KongXiangjie9612/Fruits-picking/文件/参考文献/201430220506邓镇汝/交201430220506邓镇汝/毕业设计二维/手柄的连接件-Model.jpg

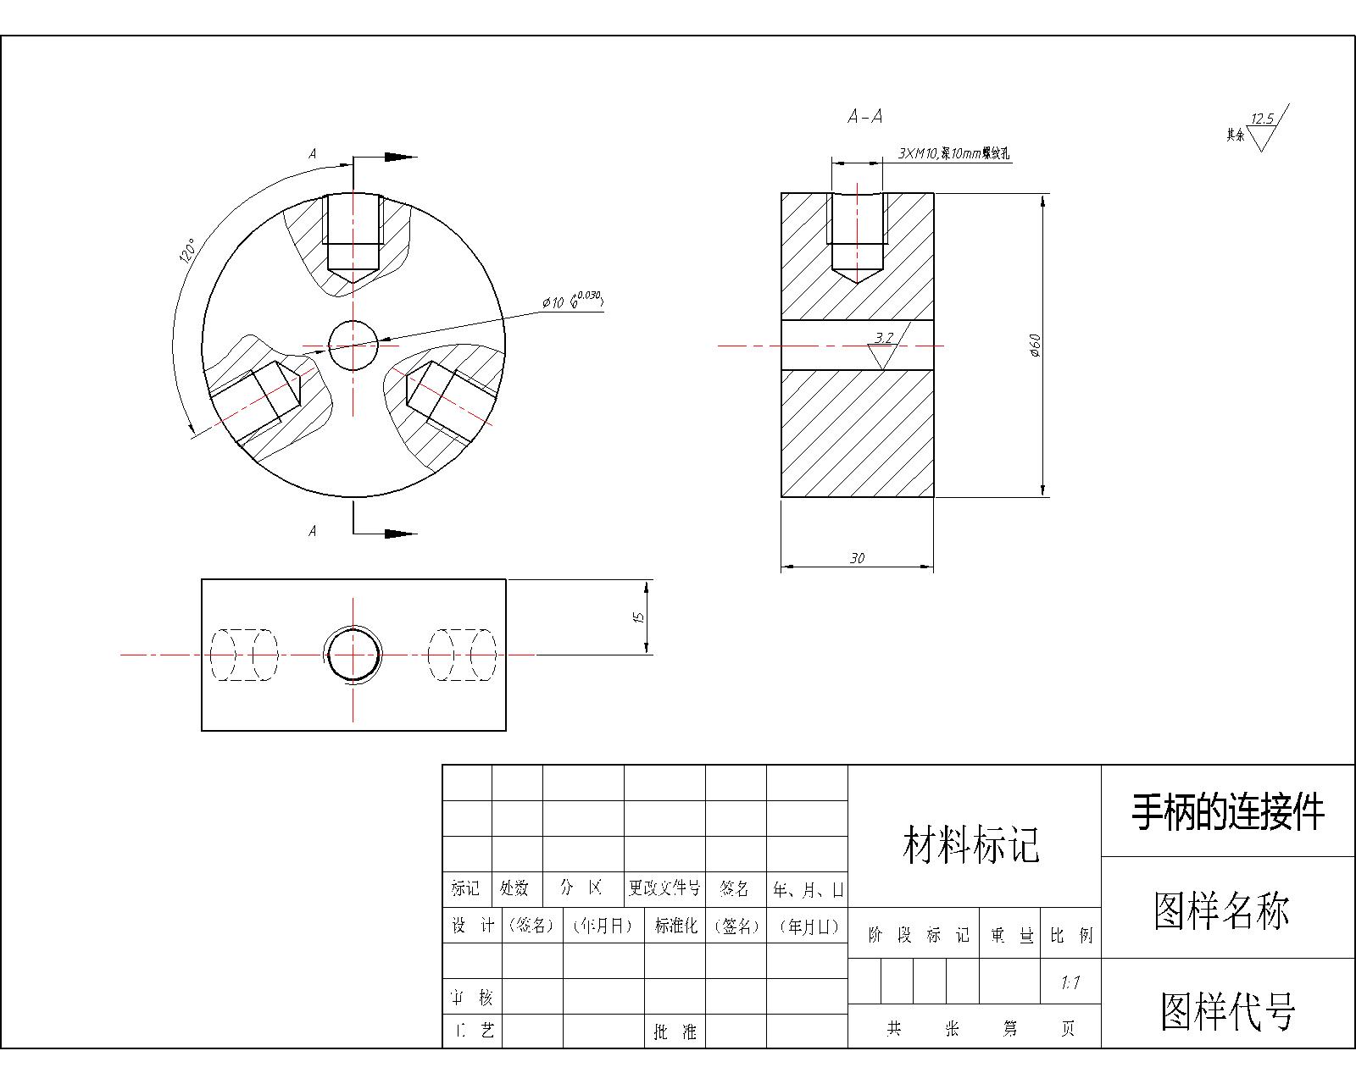
文件/参考文献/201430220506邓镇汝/交201430220506邓镇汝/毕业设计二维/手柄的连接件-Model.jpg
