KongXiangjie9612/Fruits-picking/文件/设计图纸/手持式震动采摘_零件清单.xlsx

物料名称 | 类型 | 型号规格 | 材质 | 单价 | 单机用量 | 总额 | 状态 | 入库时间 | 备注 | 购买地址
直线滑动轴承 | 加工件 | 16*23*20（内径*外径*长度） | 黄铜 | 15 | 20 | 300 |  |  |  | https://zhengkuanwj.tmall.com/shop/view_shop.htm?shop_id=110992629
