KongXiangjie9612/Fruits-picking/文件/参考文献/201430220506邓镇汝/交201430220506邓镇汝/毕业设计三维/测绘装配2.SLDASM

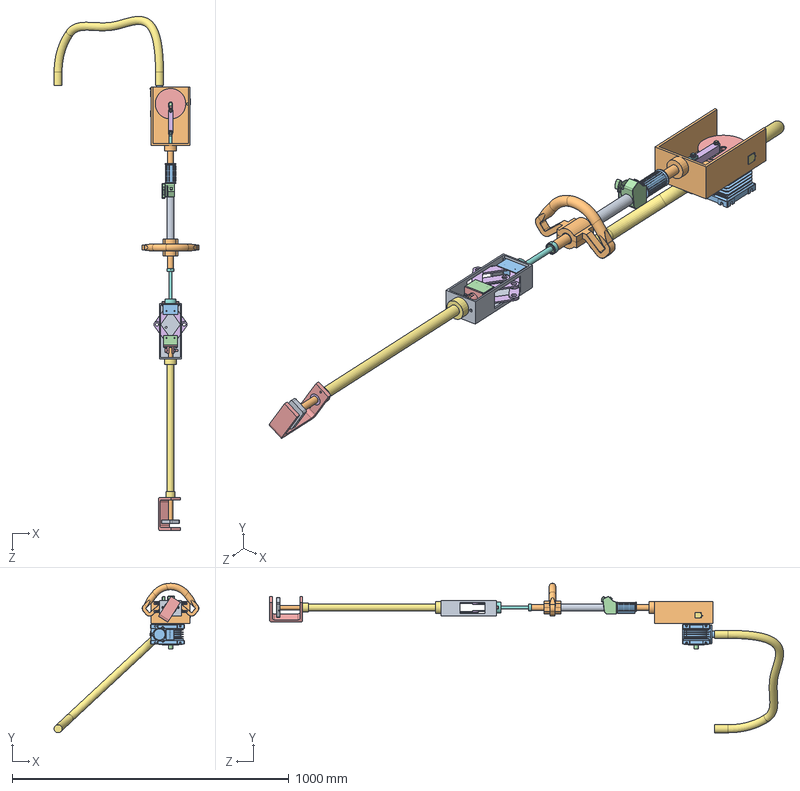
[picture p57: CAD file, 2018-09-26]
文件/参考文献/201430220506邓镇汝/交201430220506邓镇汝/毕业设计三维/测绘装配2.SLDASM
522.9 x 539.9 x 1855.7 mm
棘轮整体箱
伸出最长的长度
实际底
实际顶
连接结构2
杆 x 8
外部杆
后外部杆
顶片引用
测绘箱体杆
NMRV040测绘
测绘输出轴2
偏心盘测绘
测绘连杆1
测绘 主动销
测绘主动销2
plain washers for clevis pins gb x 2
测绘GB／T6172．1-2000六角薄螺母A级和B级M6 x 2
hexagon nuts with flange gb
测绘机箱滑动轴承16-22 x 2
测绘抓手
测绘机箱滑动轴承
紧钉管
铝管
测绘提手
测绘把手
测绘控制器
hexagon socket head cap screws gb x 5
hex nuts, style 1-grades ab gb x 5
手持震动采摘_转盘测速
