KongXiangjie9612/Fruits-picking/文件/参考文献/黄俊淮/3D建模/装夹部分.SLDASM

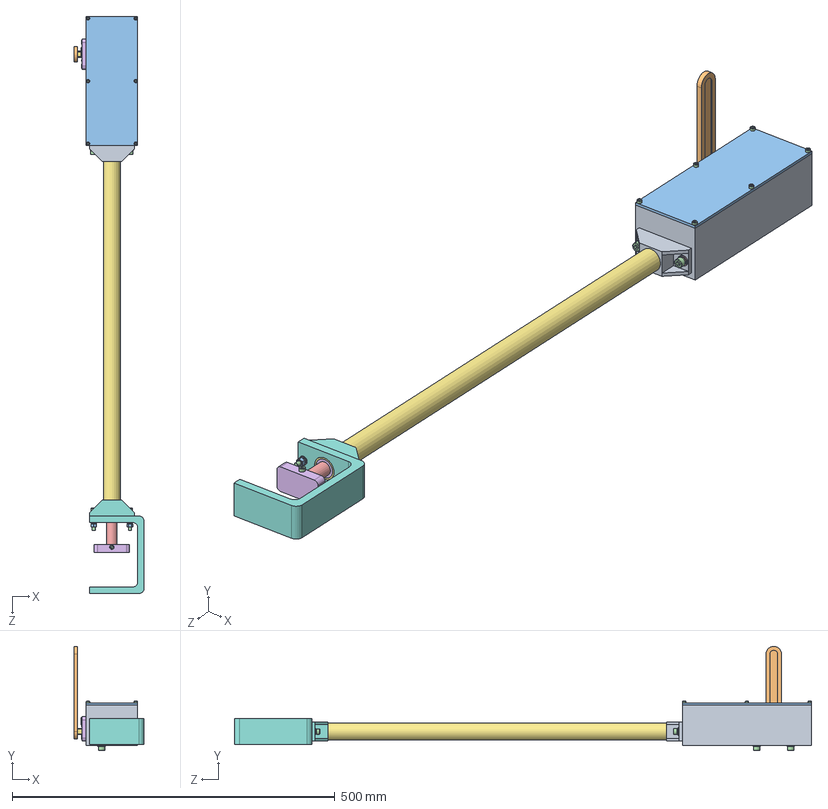
[picture p59: CAD file, 2018-09-17]
文件/参考文献/黄俊淮/3D建模/装夹部分.SLDASM
109.0 x 161.5 x 894.0 mm
棘轮整体箱
连杆2
曲柄1
棘轮轴承座
棘轮光杆2
棘轮壳
棘轮轴
棘轮凸轮
棘爪2
棘爪1
棘轮盖板
cross recessed countersunk head screws gb1
圆锥弹簧 x 2
顶片
棘轮箱杆
抓手
夹具销轴
棘轮连接扳手
hex nuts, style 1-grades ab gb x 14
hexagon socket head cap screws gb x 18
plain washers-n series-grade a gb x 19
机箱滑动轴承16-22 x 2
夹具销轴16
焊接筒
焊接筒2
spring lock washers--normal type gb x 8
cross recessed cheese head screws gb x 2
