KongXiangjie9612/Fruits-picking/文件/参考文献/黄俊淮/3D建模/装配体整体棘轮箱.SLDASM

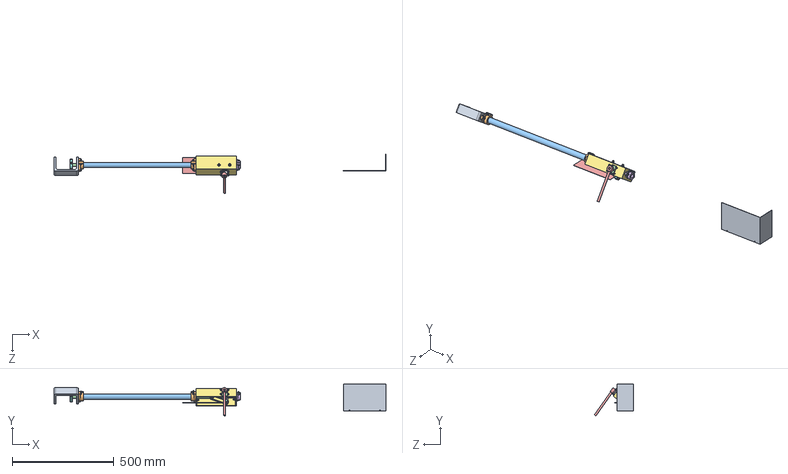
[picture p60: CAD file, 2018-09-17]
文件/参考文献/黄俊淮/3D建模/装配体整体棘轮箱.SLDASM
1634.9 x 157.5 x 194.0 mm
机箱滑动轴承16-22 x 2
棘轮箱杆
棘轮光杆2
棘轮连接扳手
曲柄1
连杆2
顶片
抓手
轴承支座26 x 2
hexagon socket head cap screws gb x 16
hex nuts, style 1-grades ab gb x 8
夹具销轴16
GB／T41-20001型六角螺母C级M5 x 2
夹具销轴
棘轮销钉
plain washers for clevis pins gb x 2
slotted set screws with cone point gb x 2
棘轮轴承座
hexagon nuts with flange gb x 2
棘轮箱轴承支座16
棘轮整体箱
