KongXiangjie9612/Fruits-picking/文件/参考文献/黄俊淮/3D建模/完整装配体.SLDASM

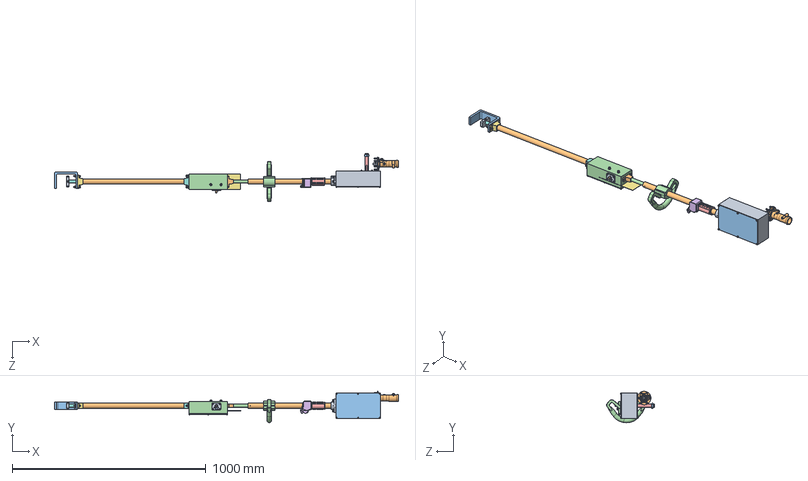
[picture p61: CAD file, 2018-09-17]
文件/参考文献/黄俊淮/3D建模/完整装配体.SLDASM
1776.1 x 162.7 x 247.0 mm
轴
轴套
hex lobular socket head cap screws-4.8 gb x 6
plain parallel keys
输出轴2
偏心盘
主动销
轴承支座26
管22-26
机箱滑动轴承16-22 x 4
箱体光杆
hexagon nuts with flange gb
hexagon socket head cap screws gb x 25
hex nuts, style 1-grades ab gb x 18
连杆1
软管连接套筒
M16薄螺母
提手
把手
控制器
plain washers for clevis pins gb x 2
slotted set screws with cone point gb
减速箱整体
销轴
棘轮整体箱
连杆2
曲柄1
棘轮轴承座
棘轮光杆2
棘轮壳
棘轮轴
棘轮凸轮
棘爪2
棘爪1
棘轮盖板
cross recessed countersunk head screws gb1 x 3
圆锥弹簧 x 2
顶片
棘轮箱杆
抓手
夹具销轴
plain washers-n series-grade a gb x 19
夹具销轴16
焊接筒
焊接筒2
spring lock washers--normal type gb x 8
中间连接焊块
棘轮箱盖板
GB_FASTENER_SCREWS_HSHCS M3X10-C x 6
