KongXiangjie9612/Fruits-picking/文件/参考文献/黄俊淮/3D建模/机构分析1.SLDASM

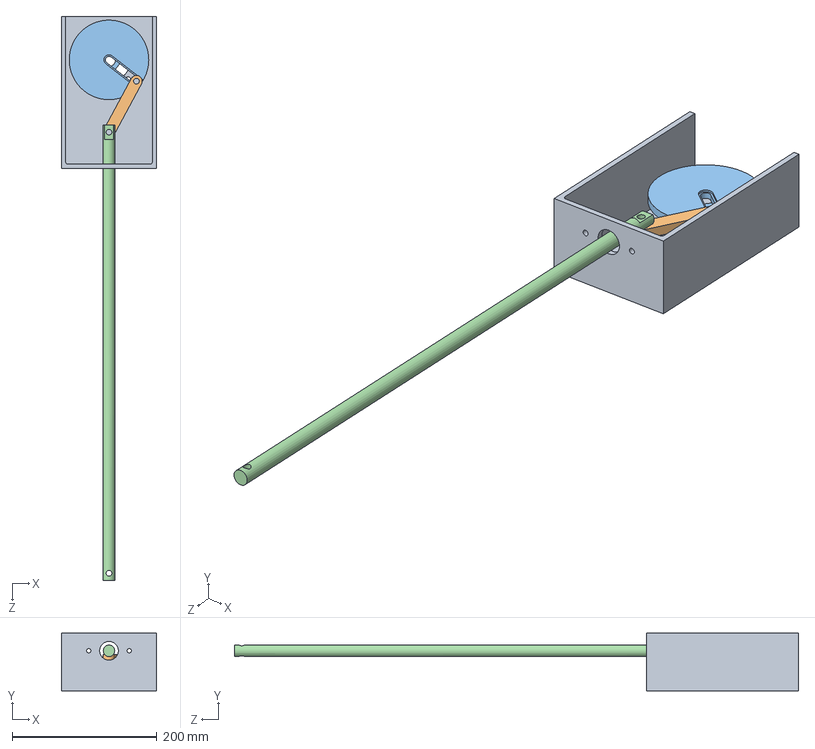
[picture p62: CAD file, 2018-09-17]
文件/参考文献/黄俊淮/3D建模/机构分析1.SLDASM
132.0 x 80.0 x 779.9 mm
减速箱整体
连杆1
偏心盘
箱体光杆
