KongXiangjie9612/Fruits-picking/文件/参考文献/李康镇/柑橘梳剪采收装置的设计-三维图/ASMBCP1.SLDASM

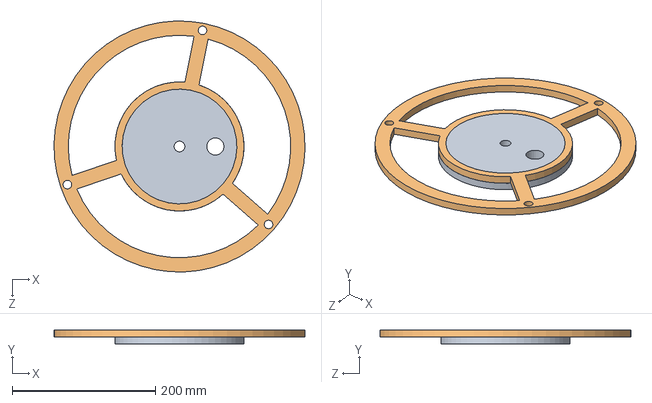
[picture p63: CAD file, 2018-09-17]
文件/参考文献/李康镇/柑橘梳剪采收装置的设计-三维图/ASMBCP1.SLDASM
349.9 x 20.0 x 349.8 mm
PRTYP1
PRTBCP2
