KongXiangjie9612/Fruits-picking/文件/参考文献/陈炜/1.2016.4.8/包含整体棘轮箱-最新/2016.01.06/装配体.SLDASM

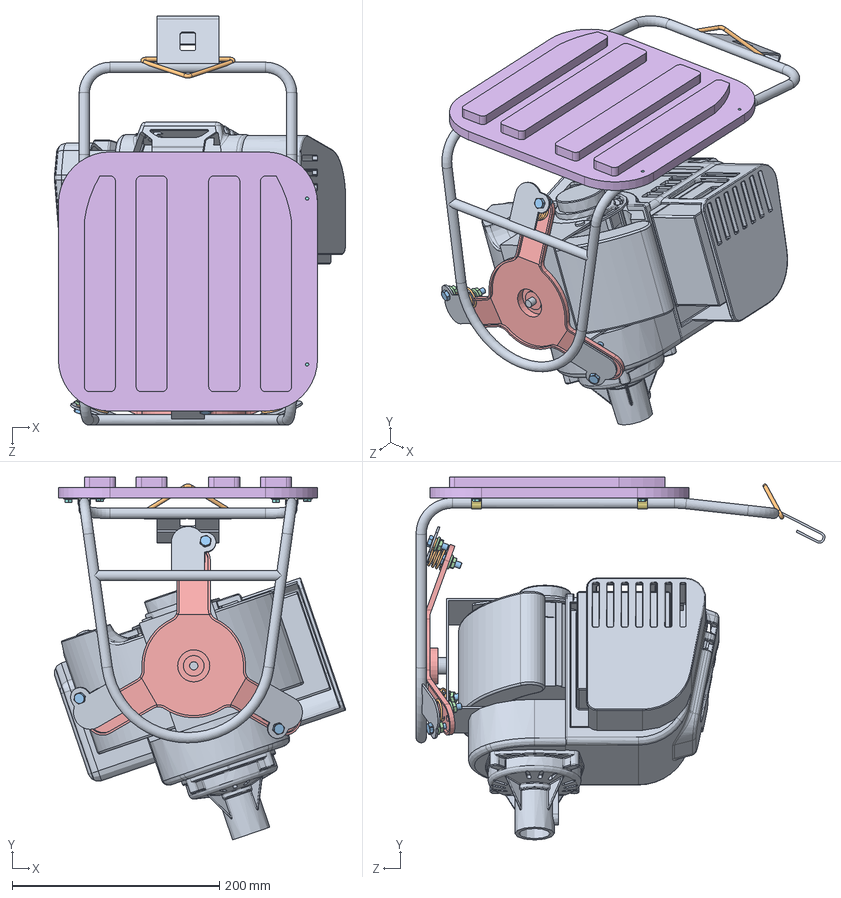
[picture p64: CAD file, 2018-09-17]
文件/参考文献/陈炜/1.2016.4.8/包含整体棘轮箱-最新/2016.01.06/装配体.SLDASM
280.9 x 350.0 x 394.5 mm
发动机支架
弹簧 x 3
hexagon head bolts-full thread gb x 7
hexagon nuts with flange gb x 6
支撑台
靠板
圆管夹块 x 4
hex bolts with slot on head grade ab gb x 8
汽油机
背带扣环
