KongXiangjie9612/Fruits-picking/文件/参考文献/黄俊淮/3D建模/零件/棘轮装配体.SLDASM

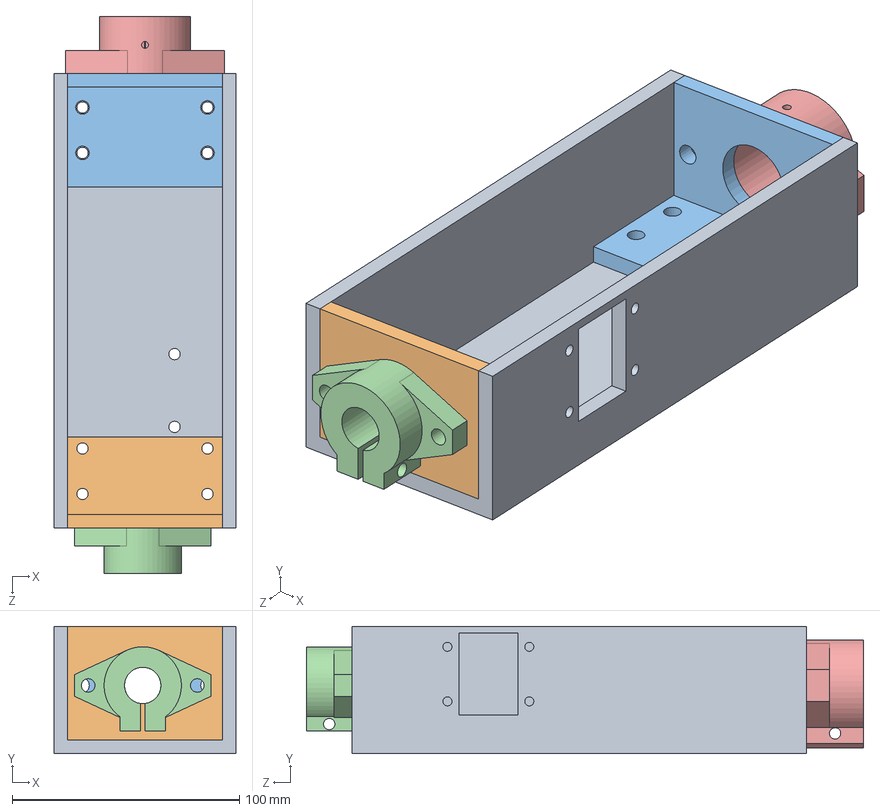
[picture p66: CAD file, 2018-09-17]
文件/参考文献/黄俊淮/3D建模/零件/棘轮装配体.SLDASM
80.0 x 56.0 x 245.0 mm
棘轮箱底板
棘轮箱端面
棘轮箱断面-25
棘轮箱轴承支座16
轴承支座26
