KongXiangjie9612/Fruits-picking/文件/参考文献/陈炜/1.2016.4.8/包含整体棘轮箱-最新/2016.01.06/装配体1.SLDASM

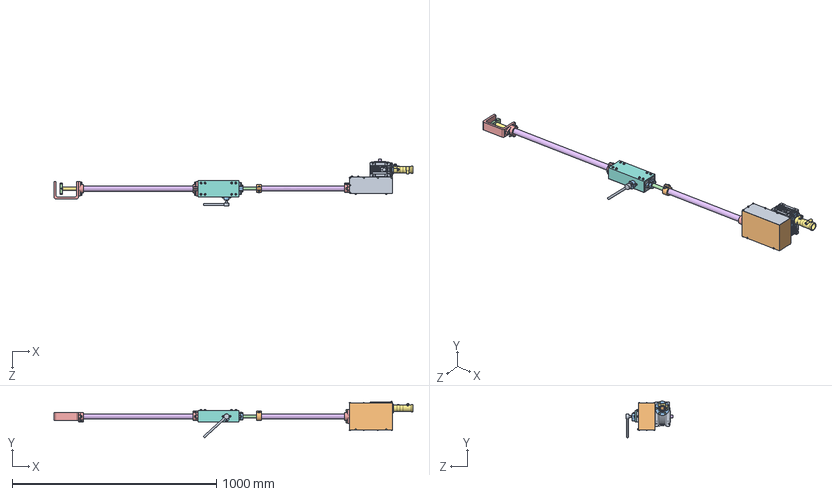
[picture p67: CAD file, 2018-09-17]
文件/参考文献/陈炜/1.2016.4.8/包含整体棘轮箱-最新/2016.01.06/装配体1.SLDASM
1755.7 x 179.8 x 231.2 mm
NMRV040
轴
轴套
hex lobular socket head cap screws-4.8 gb x 14
plain parallel keys
输出轴2
板1
直角板
底板 x 2
活动板
偏心盘
主动销
轴承支座26 x 3
管22-26
机箱滑动轴承16-22 x 4
棘轮箱底板
棘轮箱端面
棘轮箱断面-25
棘轮箱轴承支座16
箱体光杆
空心管16-20
棘轮箱杆
棘轮光杆
棘轮光杆2
棘轮连接扳手
曲柄1
连杆2
顶片
抓手
hexagon nuts with flange gb
hexagon socket head cap screws gb x 24
hex nuts, style 1-grades ab gb x 18
盖板
夹紧环
plain washers-l series-grades ac gb x 2
hexagon head bolts-full thread gb x 16
连杆1
夹具销轴 x 2
GB／T41-20001型六角螺母C级M5 x 7
棘轮轴承M8
主动销2
GB／T6172．1-2000六角薄螺母A级和B级M6 x 2
棘轮
棘轮轮齿
棘轮顶片
棘轮壳片
软管连接套筒
M5X25-N
