KongXiangjie9612/Fruits-picking/文件/参考文献/李康镇/柑橘梳剪采收装置的设计-三维图/电机装配体.SLDPRT.SLDASM

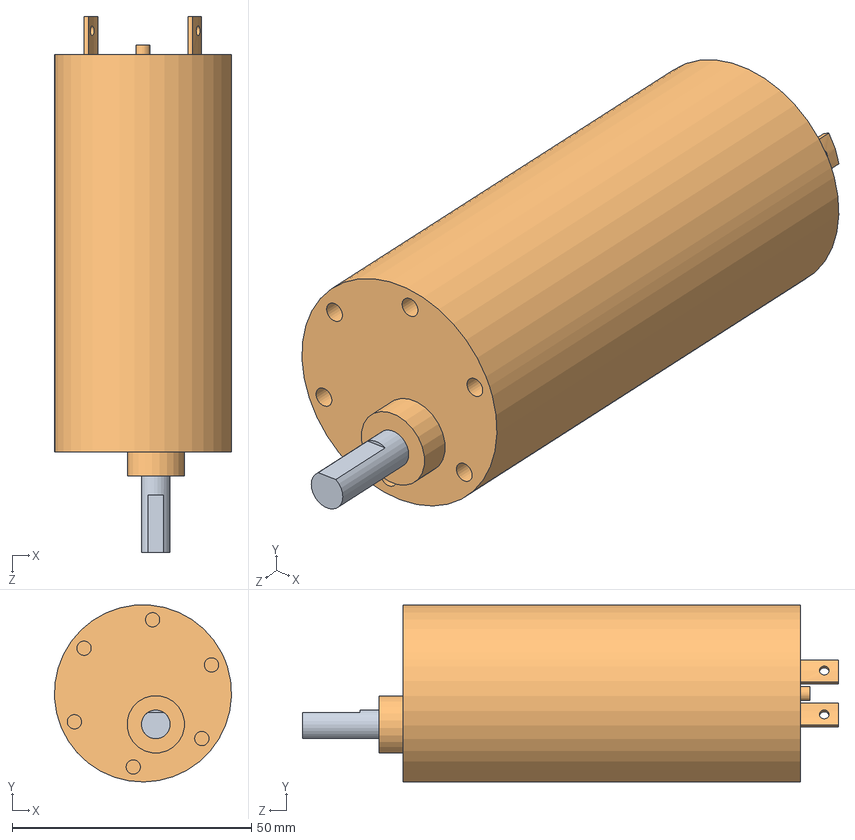
[picture p68: CAD file, 2018-09-17]
文件/参考文献/李康镇/柑橘梳剪采收装置的设计-三维图/电机装配体.SLDPRT.SLDASM
37.0 x 36.9 x 112.0 mm
电机输出轴
电机
