KongXiangjie9612/Fruits-picking/文件/参考文献/李康镇/柑橘梳剪采收装置的设计-三维图/薄膜开关2.SLDASM

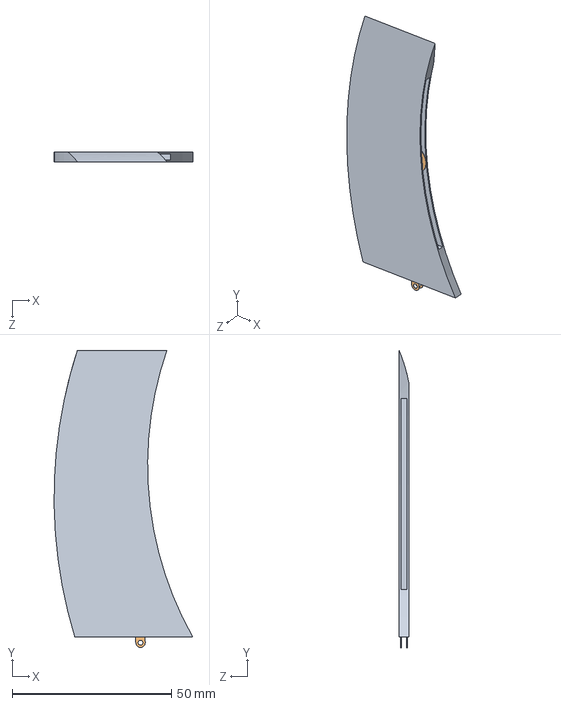
[picture p69: CAD file, 2018-09-17]
文件/参考文献/李康镇/柑橘梳剪采收装置的设计-三维图/薄膜开关2.SLDASM
43.6 x 93.2 x 3.00 mm
橡胶块2
引脚 x 2
