KongXiangjie9612/Fruits-picking/文件/参考文献/陈炜/1.2016.4.8/包含整体棘轮箱-最新/2016.01.06/装配体棘轮.SLDASM

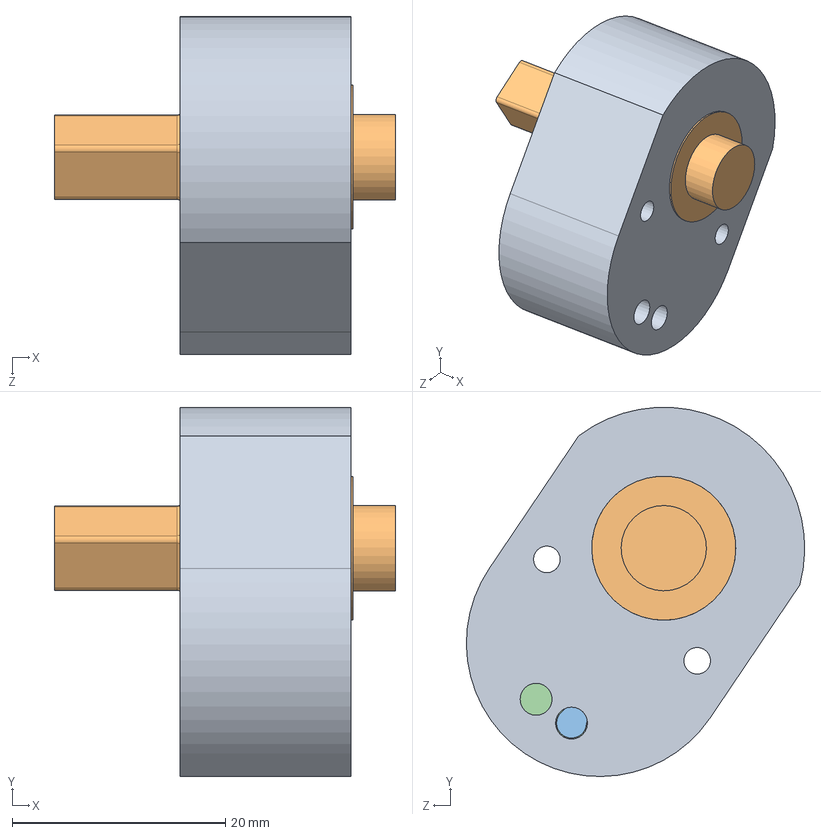
[picture p70: CAD file, 2018-09-17]
文件/参考文献/陈炜/1.2016.4.8/包含整体棘轮箱-最新/2016.01.06/装配体棘轮.SLDASM
32.0 x 34.6 x 31.7 mm
棘轮
棘轮轮齿
棘轮顶片
棘轮壳片
