KongXiangjie9612/Fruits-picking/文件/参考文献/李康镇/柑橘梳剪采收装置的设计-三维图/薄膜开关1.SLDASM

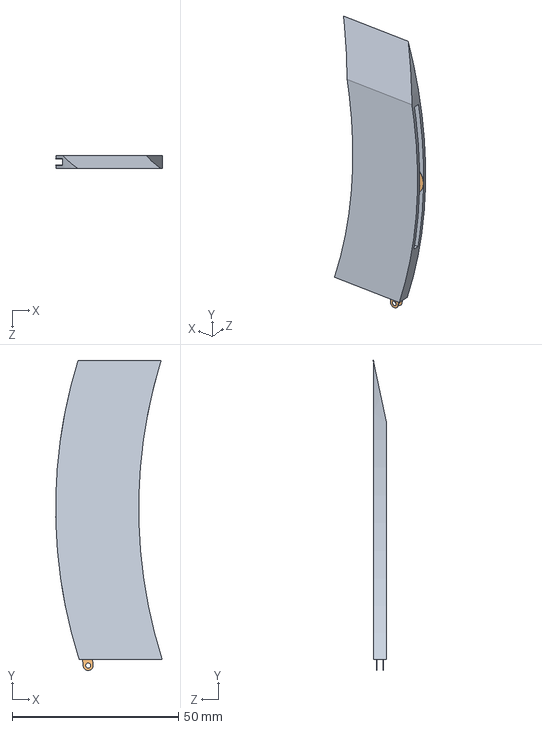
[picture p71: CAD file, 2018-09-17]
文件/参考文献/李康镇/柑橘梳剪采收装置的设计-三维图/薄膜开关1.SLDASM
32.1 x 93.2 x 4.00 mm
橡胶片
引脚 x 2
