KongXiangjie9612/Fruits-picking/文件/参考文献/陈炜/1.2016.4.8/包含整体棘轮箱-最新/2016.01.06/合叶.SLDASM

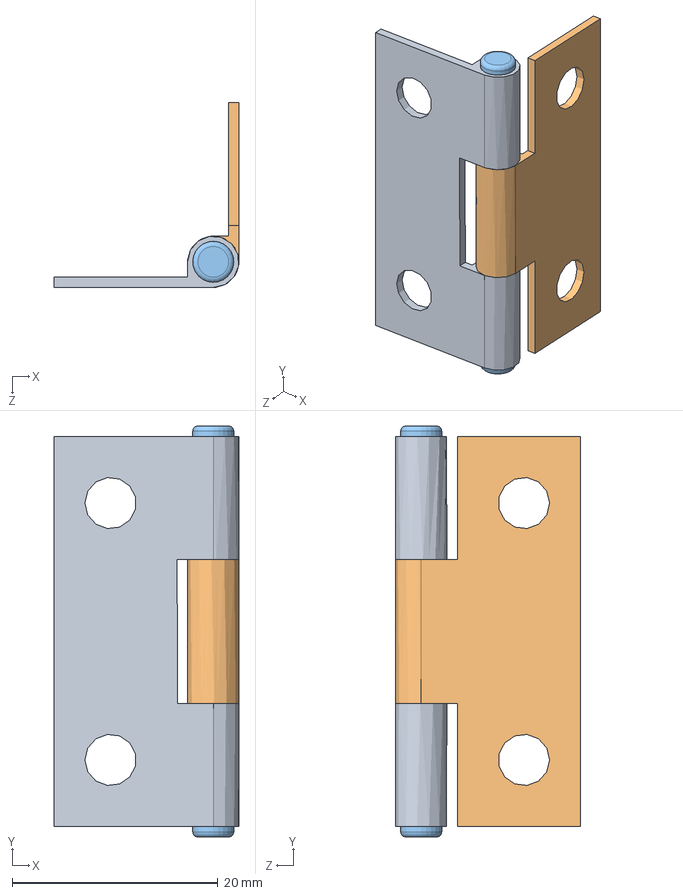
[picture p72: CAD file, 2018-09-17]
文件/参考文献/陈炜/1.2016.4.8/包含整体棘轮箱-最新/2016.01.06/合叶.SLDASM
18.0 x 40.0 x 18.0 mm
合叶片1
合叶片2
合叶销
