KongXiangjie9612/Fruits-picking/文件/参考文献/陈炜/1.2016.4.8/包含整体棘轮箱-最新/2016.01.06/装配体棘轮2.SLDASM

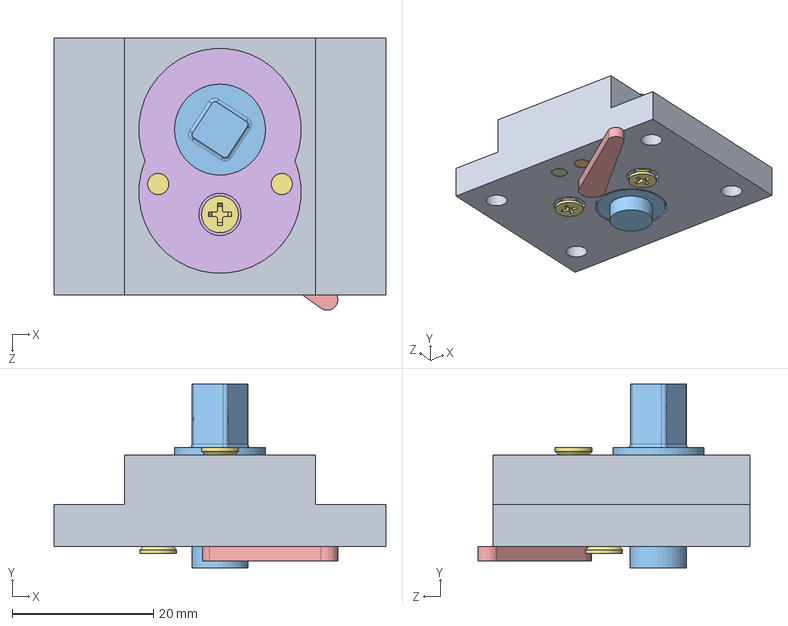
[picture p74: CAD file, 2018-09-17]
文件/参考文献/陈炜/1.2016.4.8/包含整体棘轮箱-最新/2016.01.06/装配体棘轮2.SLDASM
47.0 x 26.0 x 38.6 mm
棘轮壳
棘轮顶片右
棘轮轮齿
棘轮顶片
棘轮凸轮
棘轮盖板
cross recessed countersunk head screws gb2 x 3
