KongXiangjie9612/Fruits-picking/文件/设计图纸/毕业设计三维/测绘装配.SLDASM

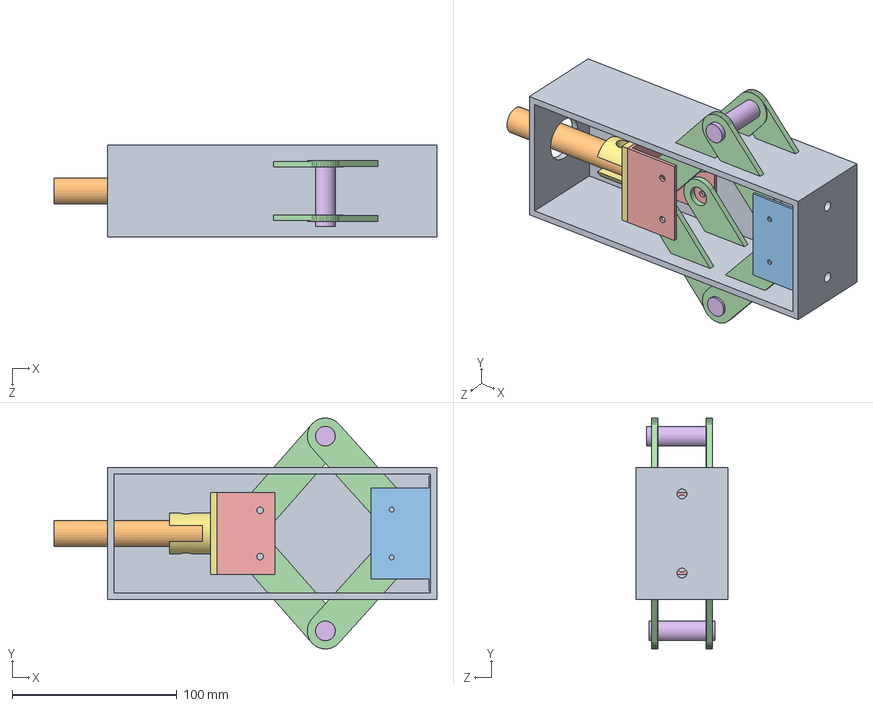
[picture p75: CAD file, 2018-09-17]
文件/设计图纸/毕业设计三维/测绘装配.SLDASM
232.3 x 140.1 x 56.0 mm
箱体
伸出最长的长度
实际底
杆 x 8
实际顶
中间连接 x 2
连接结构2
