KongXiangjie9612/Fruits-picking/文件/设计图纸/毕业设计三维/发动机装配体.SLDASM

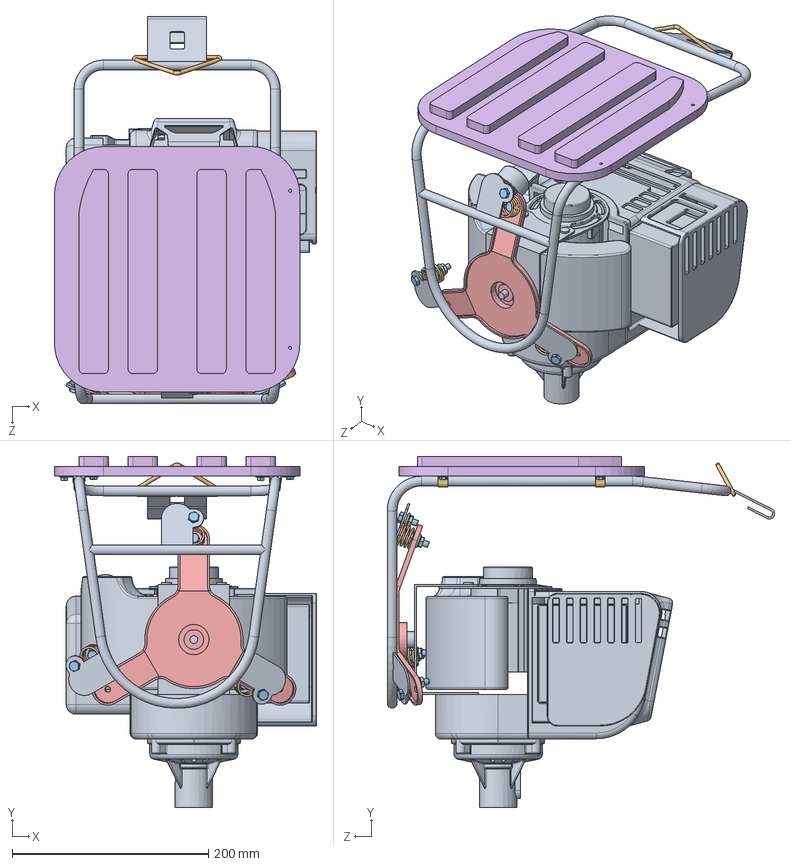
[picture p76: CAD file, 2018-09-17]
文件/设计图纸/毕业设计三维/发动机装配体.SLDASM
267.0 x 357.4 x 394.5 mm
发动机支架
弹簧 x 3
hexagon head bolts-full thread gb x 7
hexagon nuts with flange gb x 6
支撑台
靠板
圆管夹块 x 4
hex bolts with slot on head grade ab gb x 8
汽油机
背带扣环
