KongXiangjie9612/Fruits-picking/文件/参考文献/李康镇/柑橘梳剪采收装置的设计-三维图/梳齿装配体.SLDASM

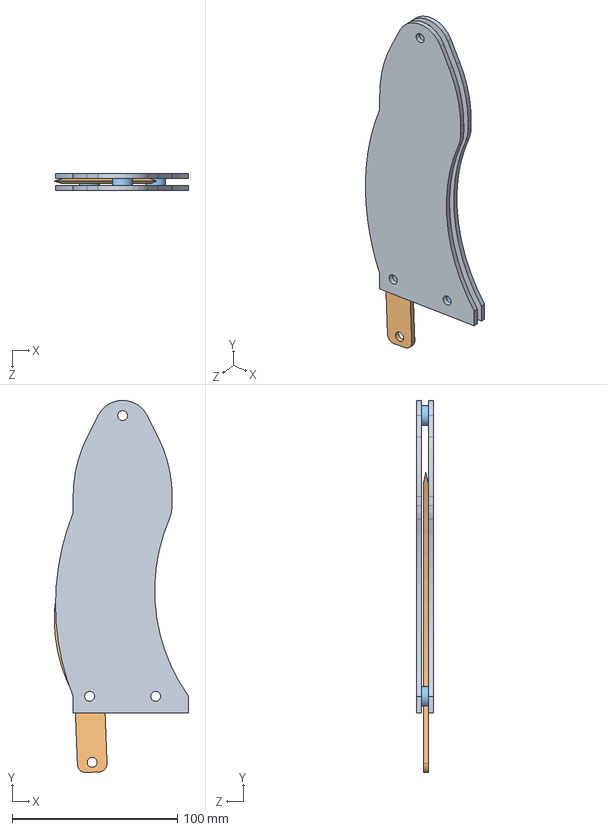
[picture p77: CAD file, 2018-09-17]
文件/参考文献/李康镇/柑橘梳剪采收装置的设计-三维图/梳齿装配体.SLDASM
81.4 x 225.3 x 10.0 mm
定刀片 x 2
动刀片
垫圈 x 3
