KongXiangjie9612/Fruits-picking/文件/设计图纸/毕业设计三维/测绘装配，只允许千进60毫米.SLDASM

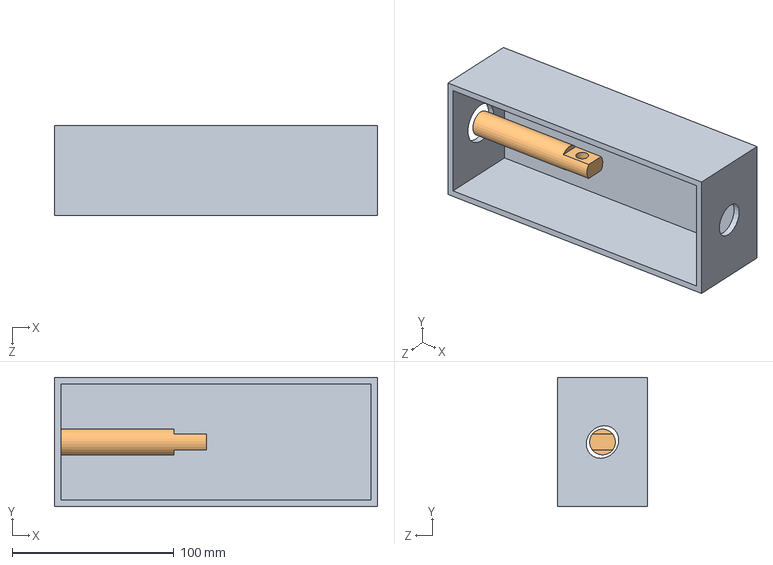
[picture p78: CAD file, 2018-09-17]
文件/设计图纸/毕业设计三维/测绘装配，只允许千进60毫米.SLDASM
200.0 x 80.0 x 56.0 mm
箱体
伸出最长的长度
