KongXiangjie9612/Fruits-picking/文件/参考文献/李康镇/柑橘梳剪采收装置的设计-三维图/曲柄摇杆机构.SLDASM

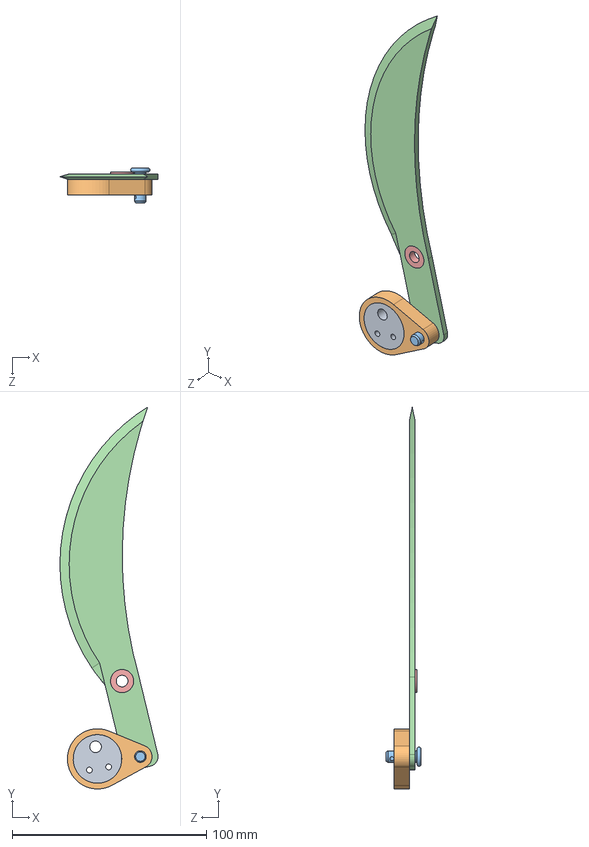
[picture p79: CAD file, 2018-09-17]
文件/参考文献/李康镇/柑橘梳剪采收装置的设计-三维图/曲柄摇杆机构.SLDASM
50.5 x 196.6 x 18.0 mm
偏心块
连杆2
M6-16销轴
动刀片
垫圈
