KongXiangjie9612/Fruits-picking/文件/参考文献/陈炜/1.2016.4.8/包含整体棘轮箱-最新/2016.01.06/棘轮装配体.SLDASM

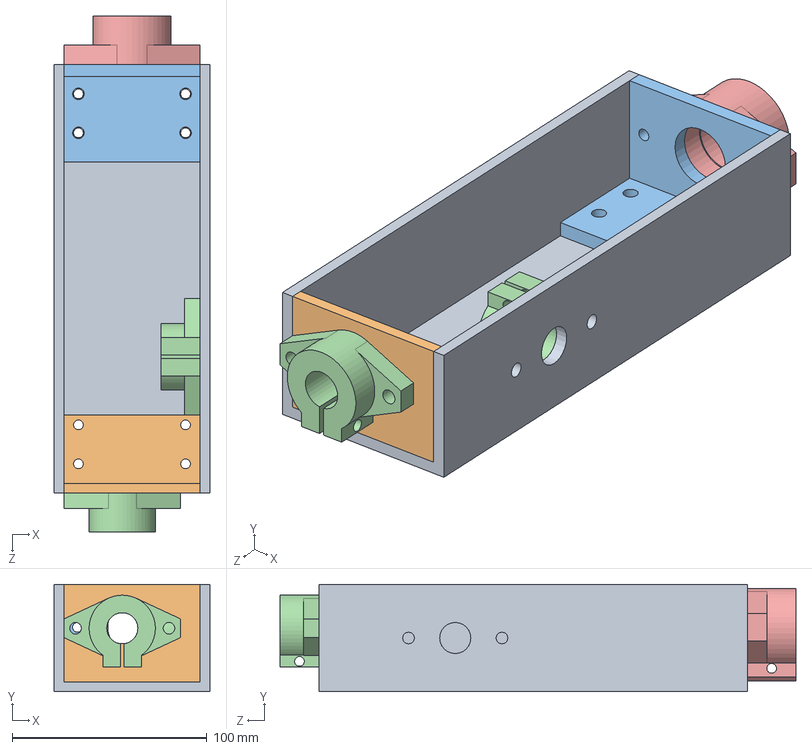
[picture p80: CAD file, 2018-09-17]
文件/参考文献/陈炜/1.2016.4.8/包含整体棘轮箱-最新/2016.01.06/棘轮装配体.SLDASM
80.0 x 55.0 x 265.0 mm
棘轮箱底板
棘轮箱端面
棘轮箱断面-25
棘轮箱轴承支座16 x 2
轴承支座26
