KongXiangjie9612/Fruits-picking/文件/参考文献/黄俊淮/3D建模/零件/减速箱.SLDASM

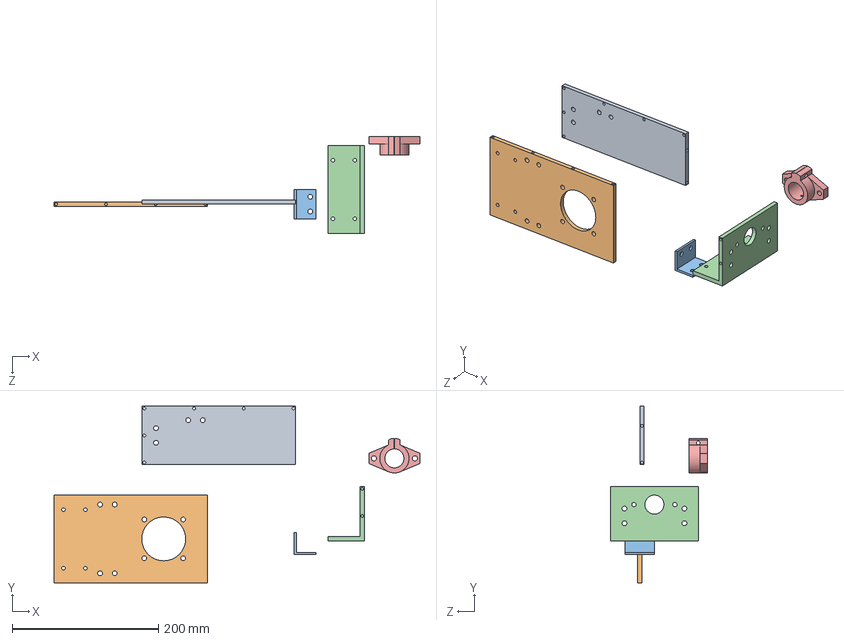
[picture p81: CAD file, 2018-09-17]
文件/参考文献/黄俊淮/3D建模/零件/减速箱.SLDASM
500.4 x 241.4 x 132.5 mm
底板
板1
固定角钢
直角板
轴承支座26
