KongXiangjie9612/Fruits-picking/文件/参考文献/陈炜/1.2016.4.8/包含整体棘轮箱-最新/2016.01.20/2016.01.20/装配体棘轮2.SLDASM

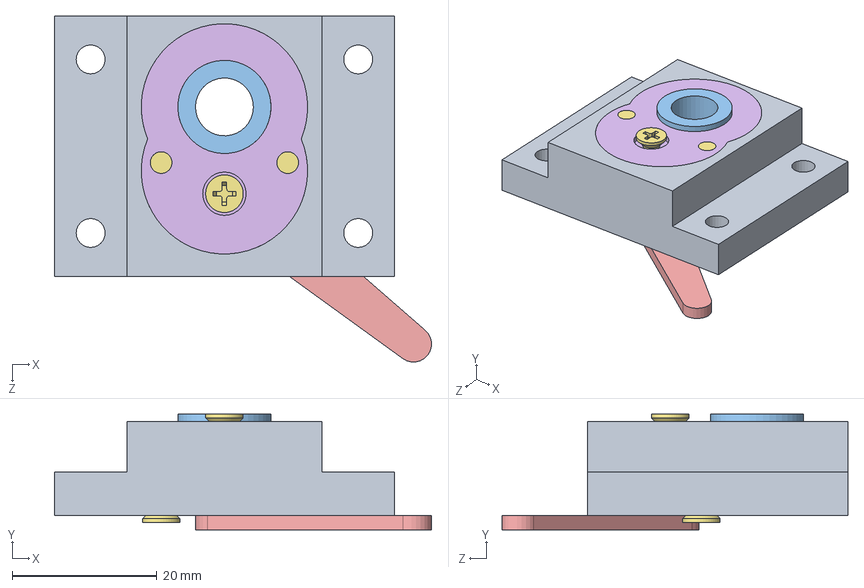
[picture p83: CAD file, 2018-09-17]
文件/参考文献/陈炜/1.2016.4.8/包含整体棘轮箱-最新/2016.01.20/2016.01.20/装配体棘轮2.SLDASM
52.1 x 16.0 x 47.8 mm
棘轮壳
棘轮顶片右
棘轮轮齿
棘轮顶片
棘轮凸轮
cross recessed countersunk head screws gb2 x 3
棘轮盖板
