KongXiangjie9612/Fruits-picking/文件/参考文献/李康镇/柑橘梳剪采收装置的设计-三维图/轴1.SLDPRT

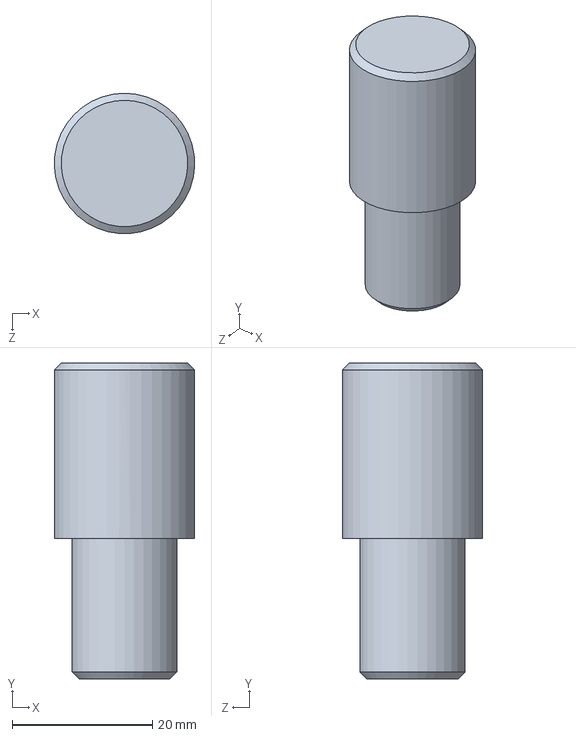
[picture p84: CAD file, 2018-09-17]
文件/参考文献/李康镇/柑橘梳剪采收装置的设计-三维图/轴1.SLDPRT
20.0 x 45.0 x 20.0 mm
