KongXiangjie9612/Fruits-picking/文件/参考文献/陈炜/1.2016.4.8/包含整体棘轮箱-最新/2016.01.06/GB／T6172．1-2000六角薄螺母A级和B级M6.SLDPRT

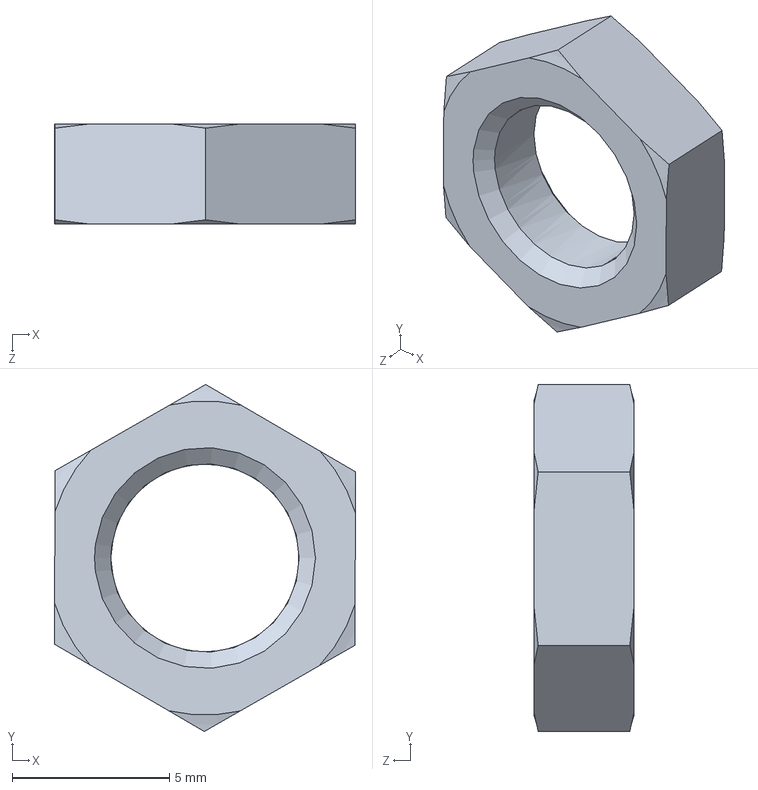
[picture p85: CAD file, 2018-09-17]
文件/参考文献/陈炜/1.2016.4.8/包含整体棘轮箱-最新/2016.01.06/GB／T6172．1-2000六角薄螺母A级和B级M6.SLDPRT
9.59 x 11.0 x 3.20 mm
