KongXiangjie9612/Fruits-picking/文件/参考文献/陈炜/1.2016.4.8/包含整体棘轮箱-最新/2016.01.20/2016.01.20/棘轮整体箱.SLDPRT

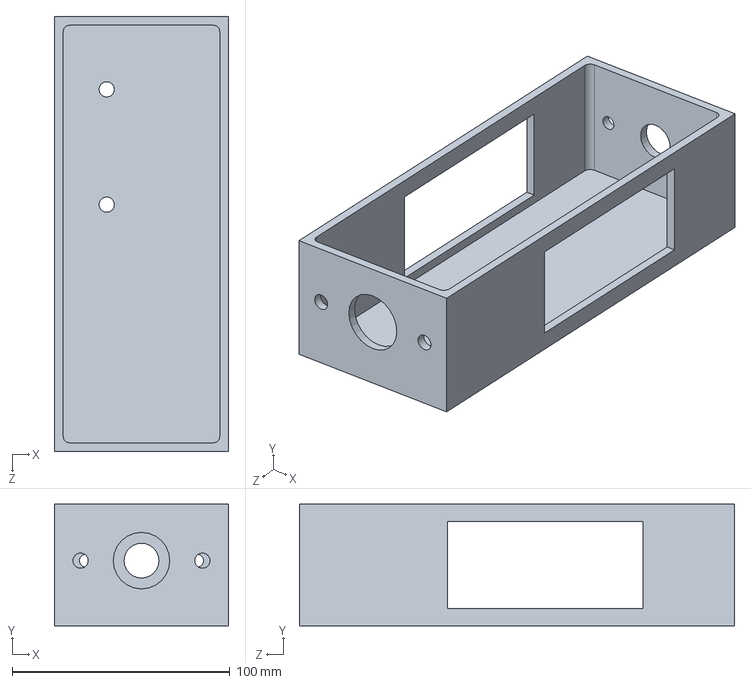
[picture p86: CAD file, 2018-09-26]
文件/参考文献/陈炜/1.2016.4.8/包含整体棘轮箱-最新/2016.01.20/2016.01.20/棘轮整体箱.SLDPRT
80.0 x 56.0 x 200.0 mm
