KongXiangjie9612/Fruits-picking/文件/参考文献/黄俊淮/3D建模/标准件/棘轮螺钉1.SLDPRT

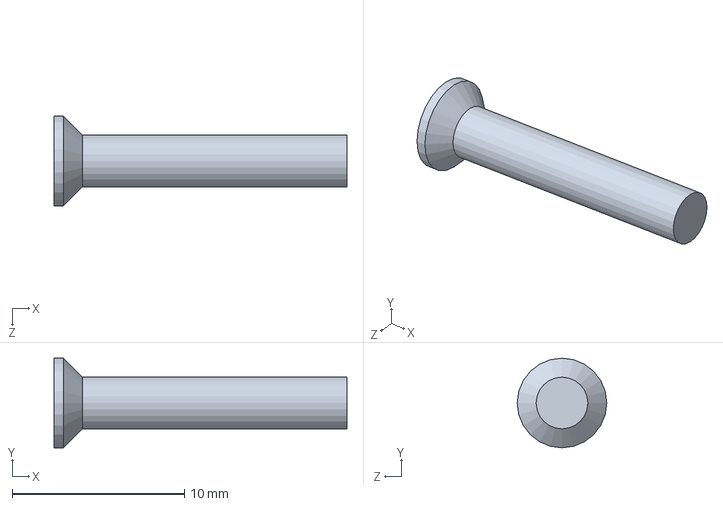
[picture p87: CAD file, 2018-09-17]
文件/参考文献/黄俊淮/3D建模/标准件/棘轮螺钉1.SLDPRT
17.0 x 5.20 x 5.20 mm
