KongXiangjie9612/Fruits-picking/文件/参考文献/黄俊淮/3D建模/零件/弹簧.SLDPRT

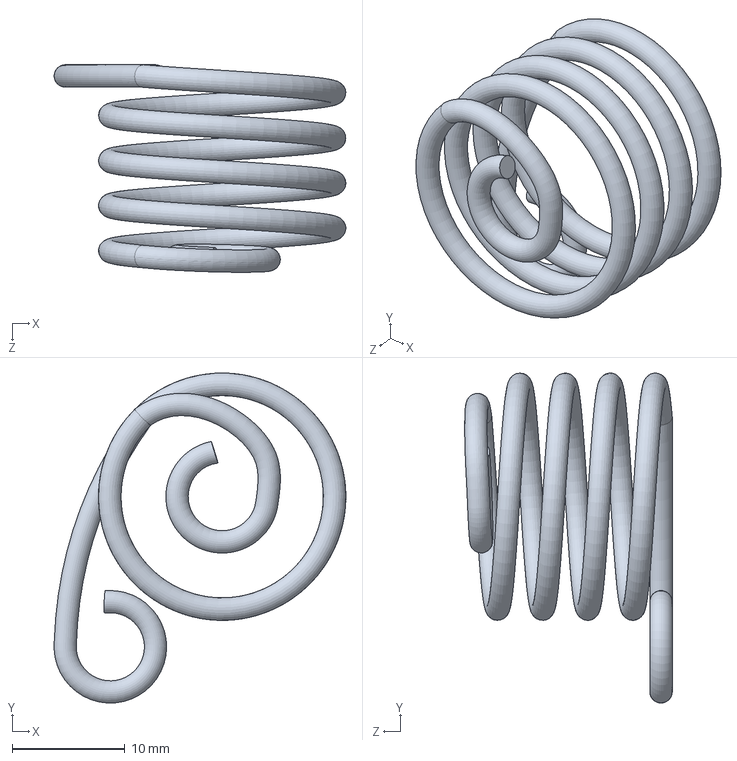
[picture p88: CAD file, 2018-09-17]
文件/参考文献/黄俊淮/3D建模/零件/弹簧.SLDPRT
25.9 x 29.2 x 18.4 mm
