KongXiangjie9612/Fruits-picking/文件/设计图纸/毕业设计三维/二维/连接结构2.SLDPRT

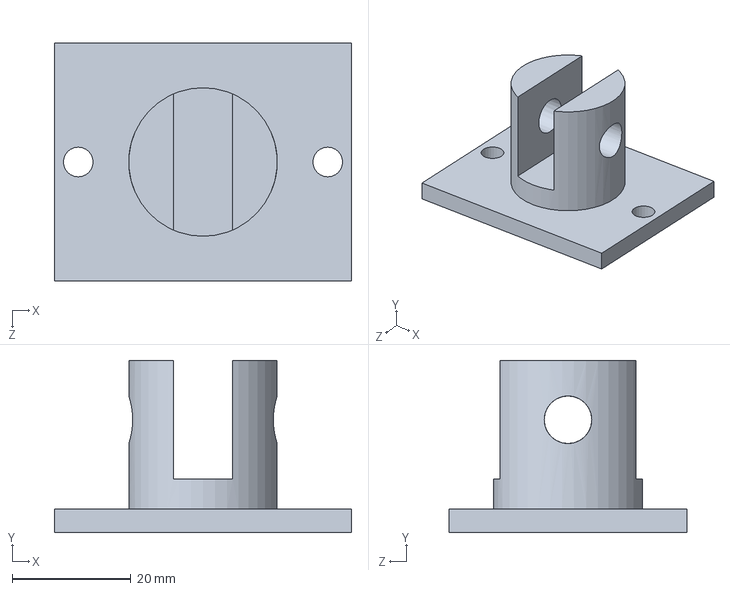
[picture p89: CAD file, 2018-09-17]
文件/设计图纸/毕业设计三维/二维/连接结构2.SLDPRT
50.0 x 29.0 x 40.0 mm
