KongXiangjie9612/Fruits-picking/文件/设计图纸/毕业设计三维/后外部杆.SLDPRT

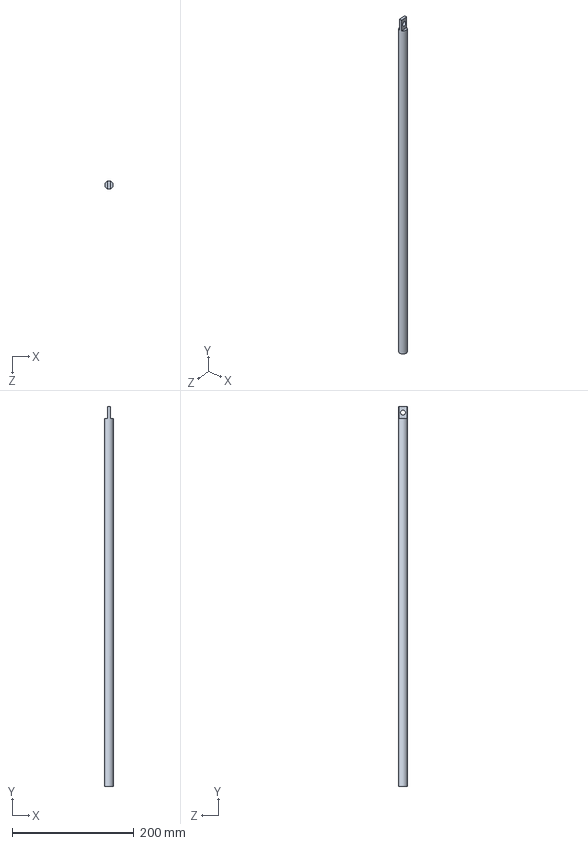
[picture p90: CAD file, 2018-10-24]
文件/设计图纸/毕业设计三维/后外部杆.SLDPRT
14.0 x 625.0 x 14.0 mm
