KongXiangjie9612/Fruits-picking/文件/参考文献/201430220506邓镇汝/交201430220506邓镇汝/毕业设计三维/实际底.SLDPRT

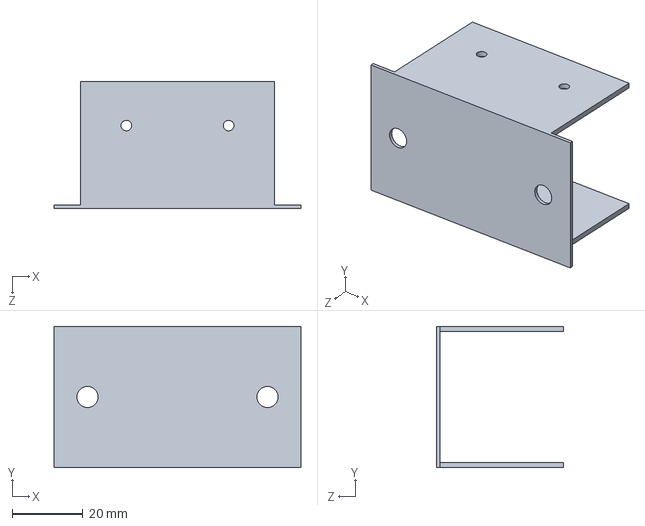
[picture p91: CAD file, 2018-09-26]
文件/参考文献/201430220506邓镇汝/交201430220506邓镇汝/毕业设计三维/实际底.SLDPRT
70.0 x 40.0 x 36.0 mm
