KongXiangjie9612/Fruits-picking/文件/参考文献/李康镇/柑橘梳剪采收装置的设计-三维图/挡圈.SLDPRT

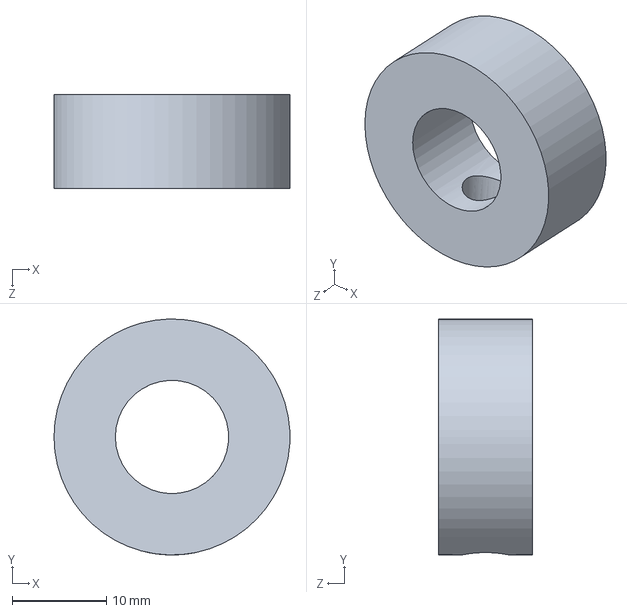
[picture p92: CAD file, 2018-09-17]
文件/参考文献/李康镇/柑橘梳剪采收装置的设计-三维图/挡圈.SLDPRT
25.0 x 25.0 x 10.0 mm
