KongXiangjie9612/Fruits-picking/文件/参考文献/黄俊淮/3D建模/标准件/夹紧环.SLDPRT

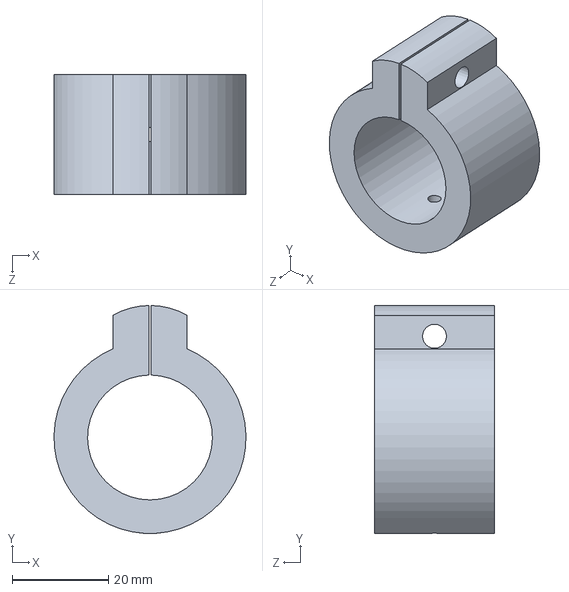
[picture p95: CAD file, 2018-09-17]
文件/参考文献/黄俊淮/3D建模/标准件/夹紧环.SLDPRT
40.0 x 47.5 x 25.0 mm
