KongXiangjie9612/Fruits-picking/文件/参考文献/黄俊淮/3D建模/标准件2/机箱滑动轴承16-22.SLDPRT

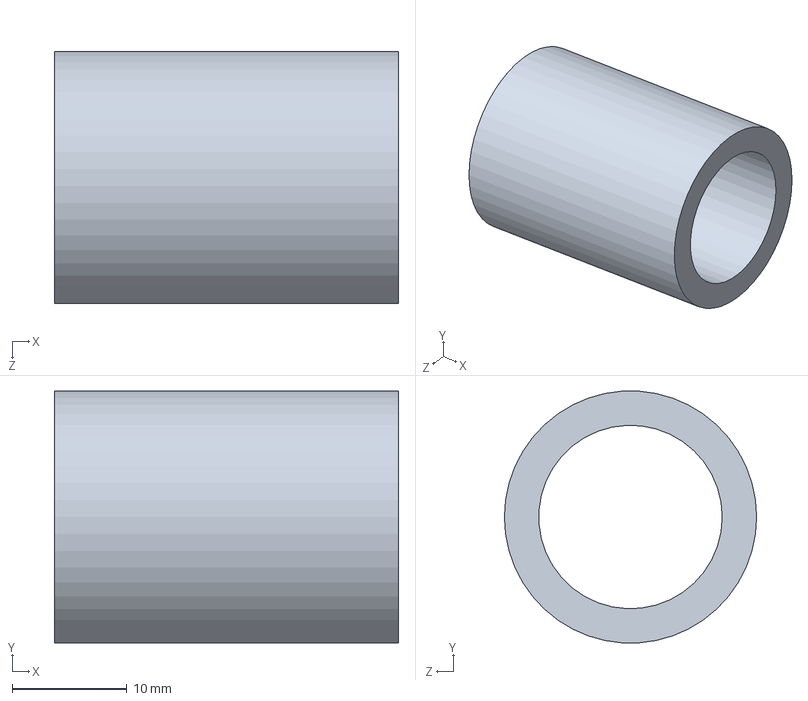
[picture p96: CAD file, 2018-09-17]
文件/参考文献/黄俊淮/3D建模/标准件2/机箱滑动轴承16-22.SLDPRT
30.0 x 21.9 x 22.0 mm
