KongXiangjie9612/Fruits-picking/文件/参考文献/黄俊淮/3D建模/零件/输出轴2.SLDPRT

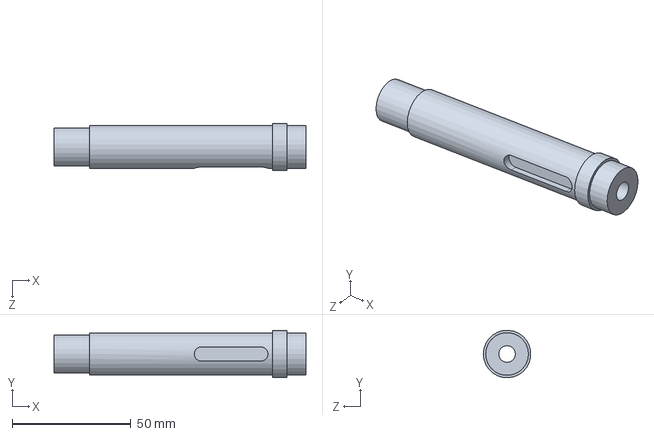
[picture p97: CAD file, 2018-09-17]
文件/参考文献/黄俊淮/3D建模/零件/输出轴2.SLDPRT
106.0 x 20.0 x 19.9 mm
