KongXiangjie9612/Fruits-picking/文件/设计图纸/毕业设计三维/外部杆.SLDPRT

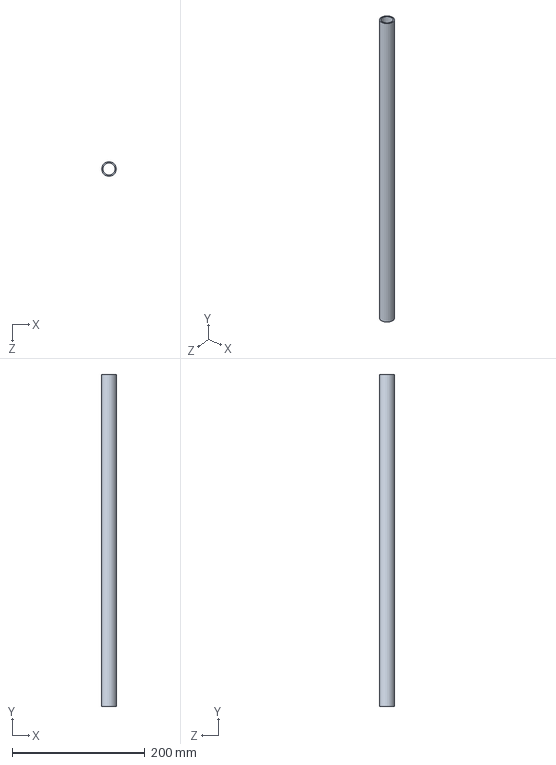
[picture p98: CAD file, 2018-10-24]
文件/设计图纸/毕业设计三维/外部杆.SLDPRT
22.0 x 500.0 x 22.0 mm
