KongXiangjie9612/Fruits-picking/文件/参考文献/201430220506邓镇汝/交201430220506邓镇汝/毕业设计三维/测绘箱体杆.SLDPRT

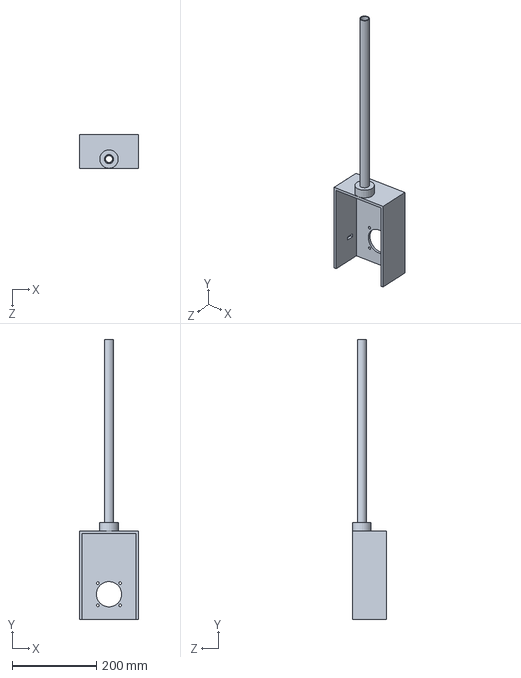
[picture p99: CAD file, 2018-09-26]
文件/参考文献/201430220506邓镇汝/交201430220506邓镇汝/毕业设计三维/测绘箱体杆.SLDPRT
140.0 x 665.0 x 80.0 mm
