KongXiangjie9612/Fruits-picking/文件/参考文献/李康镇/柑橘梳剪采收装置的设计-三维图/PRTBCP1.SLDPRT

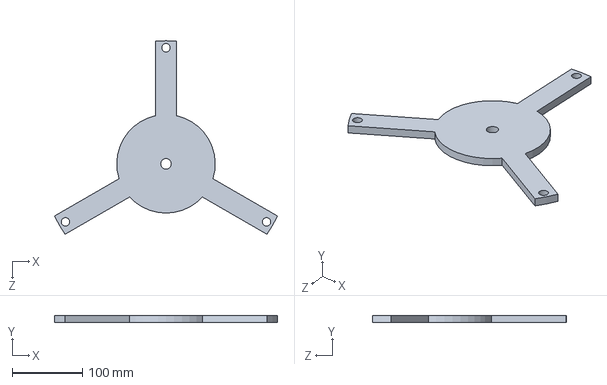
[picture p100: CAD file, 2018-09-17]
文件/参考文献/李康镇/柑橘梳剪采收装置的设计-三维图/PRTBCP1.SLDPRT
317.0 x 10.0 x 275.2 mm
