KongXiangjie9612/Fruits-picking/文件/参考文献/陈炜/1.2016.4.8/包含整体棘轮箱-最新/2016.01.06/棘轮箱杆.SLDPRT

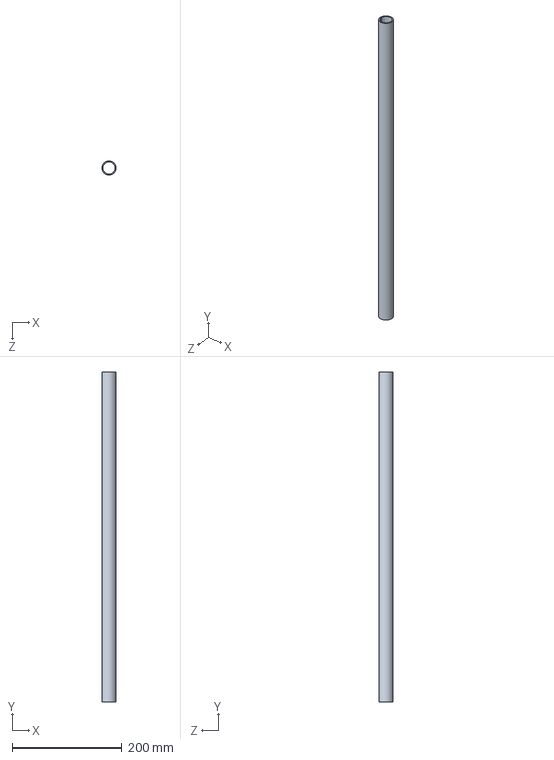
[picture p101: CAD file, 2018-09-17]
文件/参考文献/陈炜/1.2016.4.8/包含整体棘轮箱-最新/2016.01.06/棘轮箱杆.SLDPRT
26.0 x 600.0 x 26.0 mm
