KongXiangjie9612/Fruits-picking/文件/参考文献/陈炜/1.2016.4.8/包含整体棘轮箱-最新/2016.01.20/2016.01.20/发动机支架.SLDPRT

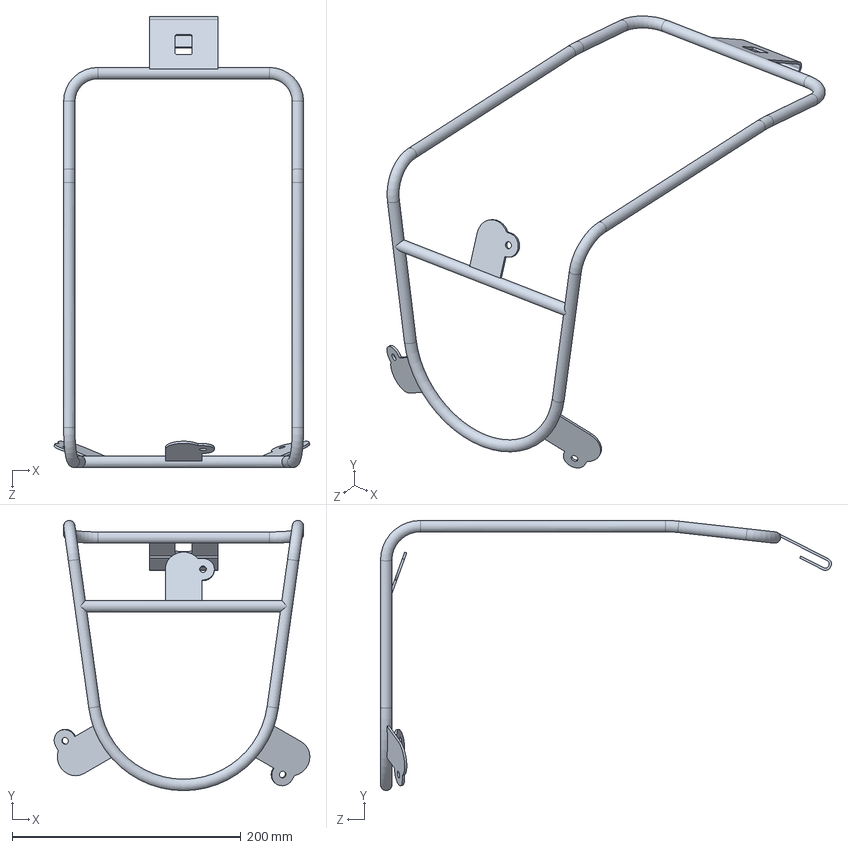
[picture p102: CAD file, 2018-09-17]
文件/参考文献/陈炜/1.2016.4.8/包含整体棘轮箱-最新/2016.01.20/2016.01.20/发动机支架.SLDPRT
223.7 x 236.4 x 394.5 mm
