KongXiangjie9612/Fruits-picking/文件/参考文献/黄俊淮/3D建模/标准件/棘轮螺钉2.SLDPRT

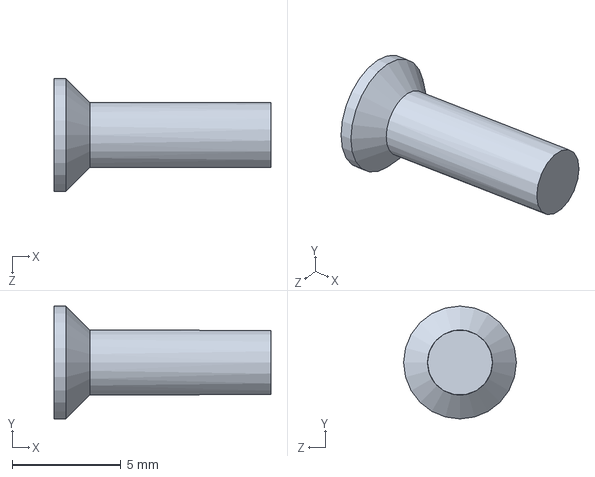
[picture p103: CAD file, 2018-09-17]
文件/参考文献/黄俊淮/3D建模/标准件/棘轮螺钉2.SLDPRT
10.0 x 5.20 x 5.20 mm
