KongXiangjie9612/Fruits-picking/文件/参考文献/黄俊淮/3D建模/标准件2/六角螺母M5.SLDPRT

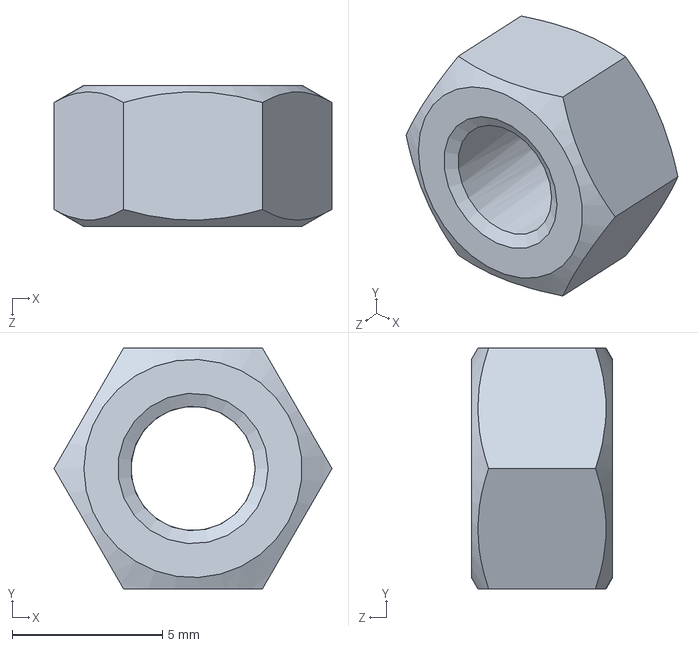
[picture p104: CAD file, 2018-09-17]
文件/参考文献/黄俊淮/3D建模/标准件2/六角螺母M5.SLDPRT
9.24 x 8.00 x 4.70 mm
