KongXiangjie9612/Fruits-picking/文件/参考文献/黄俊淮/3D建模/零件/软管连接套筒.SLDPRT

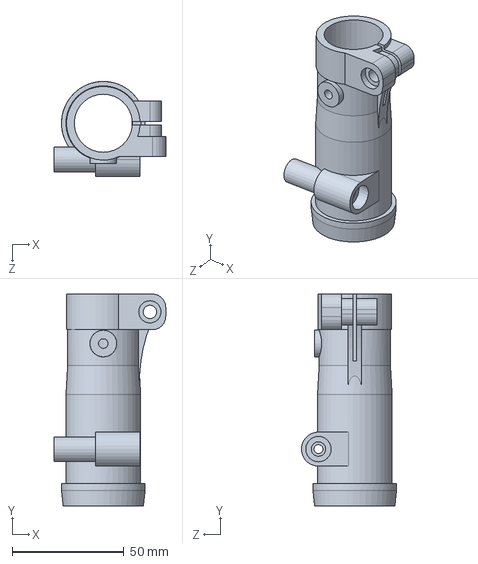
[picture p105: CAD file, 2018-09-17]
文件/参考文献/黄俊淮/3D建模/零件/软管连接套筒.SLDPRT
50.0 x 95.0 x 42.7 mm
