KongXiangjie9612/Fruits-picking/文件/设计图纸/毕业设计三维/测绘箱体杆.SLDPRT

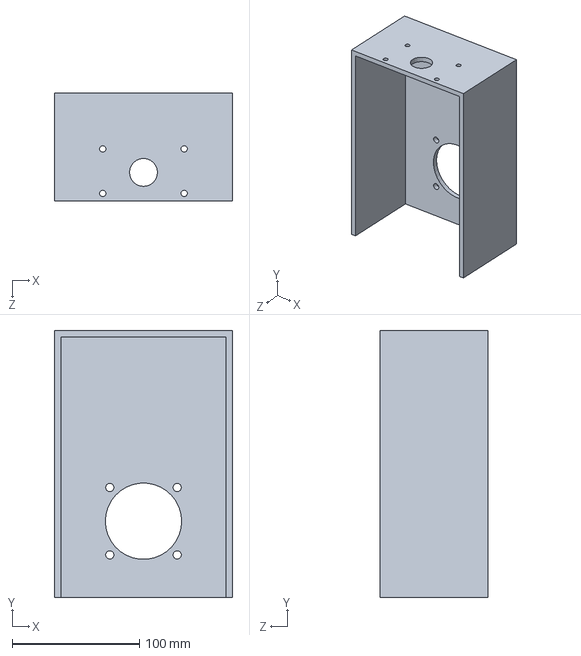
[picture p106: CAD file, 2018-10-24]
文件/设计图纸/毕业设计三维/测绘箱体杆.SLDPRT
140.0 x 210.0 x 85.0 mm
