KongXiangjie9612/Fruits-picking/文件/参考文献/201430220506邓镇汝/交201430220506邓镇汝/毕业设计三维/偏心盘测绘.SLDPRT

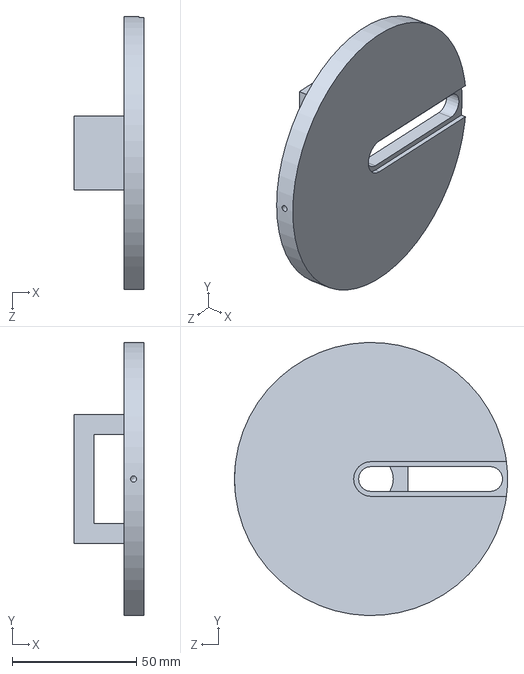
[picture p107: CAD file, 2018-09-26]
文件/参考文献/201430220506邓镇汝/交201430220506邓镇汝/毕业设计三维/偏心盘测绘.SLDPRT
28.0 x 110.0 x 110.0 mm
