KongXiangjie9612/Fruits-picking/文件/参考文献/陈炜/1.2016.4.8/包含整体棘轮箱-最新/2016.01.06/空心管16-20.SLDPRT

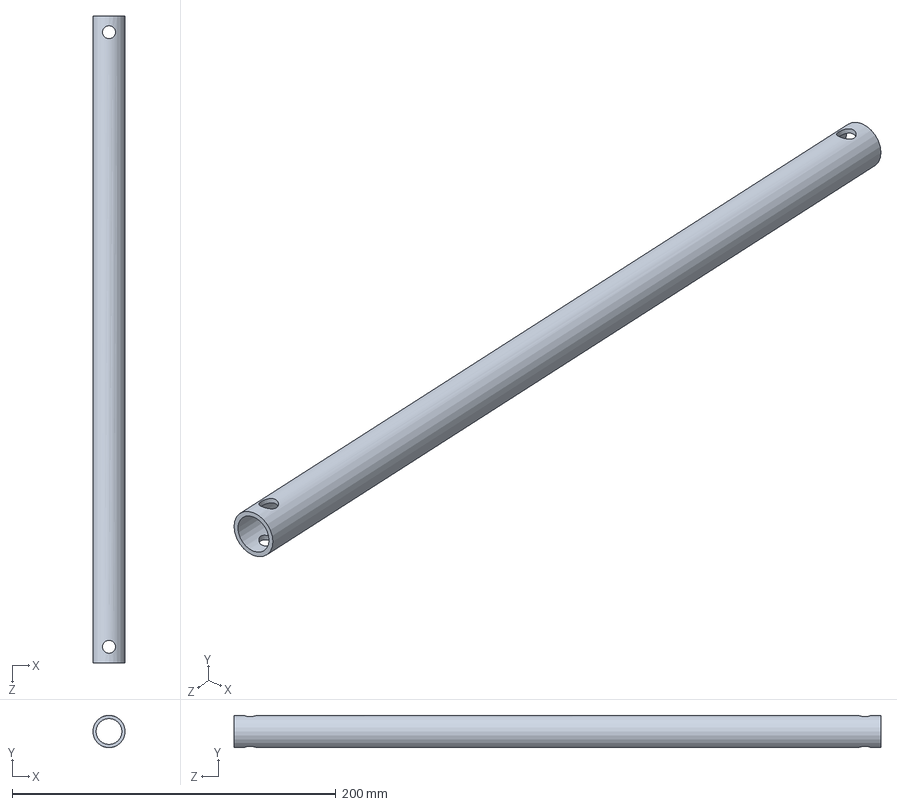
[picture p109: CAD file, 2018-09-17]
文件/参考文献/陈炜/1.2016.4.8/包含整体棘轮箱-最新/2016.01.06/空心管16-20.SLDPRT
20.0 x 20.0 x 400.0 mm
