KongXiangjie9612/Fruits-picking/文件/参考文献/陈炜/1.2016.4.8/包含整体棘轮箱-最新/2016.01.20/2016.01.20/夹头橡胶垫.SLDPRT

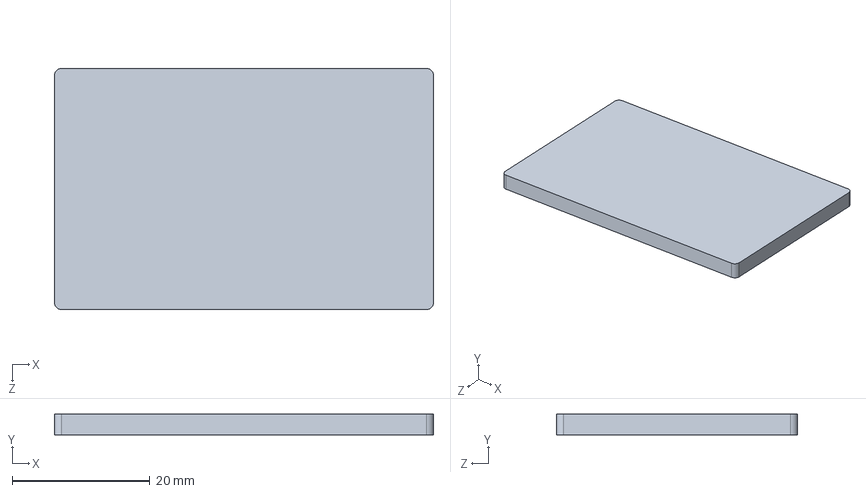
[picture p110: CAD file, 2018-09-17]
文件/参考文献/陈炜/1.2016.4.8/包含整体棘轮箱-最新/2016.01.20/2016.01.20/夹头橡胶垫.SLDPRT
55.0 x 3.00 x 35.0 mm
