KongXiangjie9612/Fruits-picking/文件/参考文献/黄俊淮/3D建模/标准件/内六角圆柱头螺钉-M6x30.SLDPRT

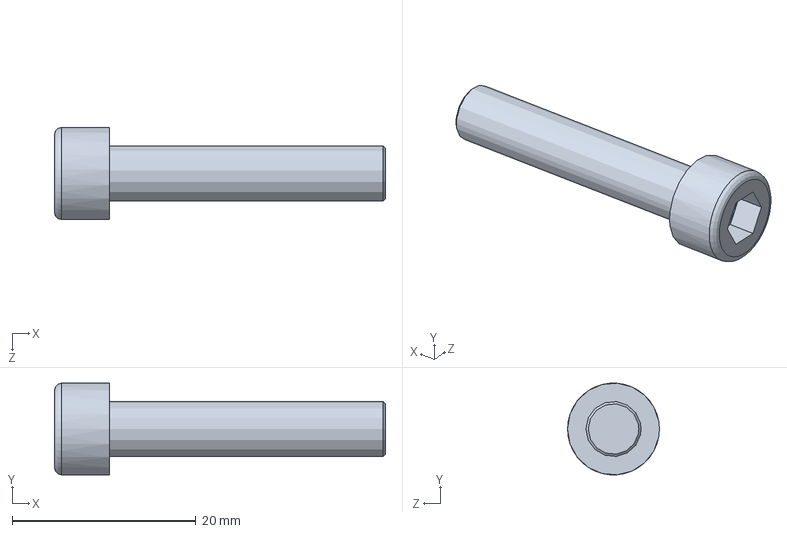
[picture p111: CAD file, 2018-09-17]
文件/参考文献/黄俊淮/3D建模/标准件/内六角圆柱头螺钉-M6x30.SLDPRT
36.0 x 9.97 x 10.0 mm
