KongXiangjie9612/Fruits-picking/文件/参考文献/黄俊淮/3D建模/零件/棘轮轴承M8.SLDPRT

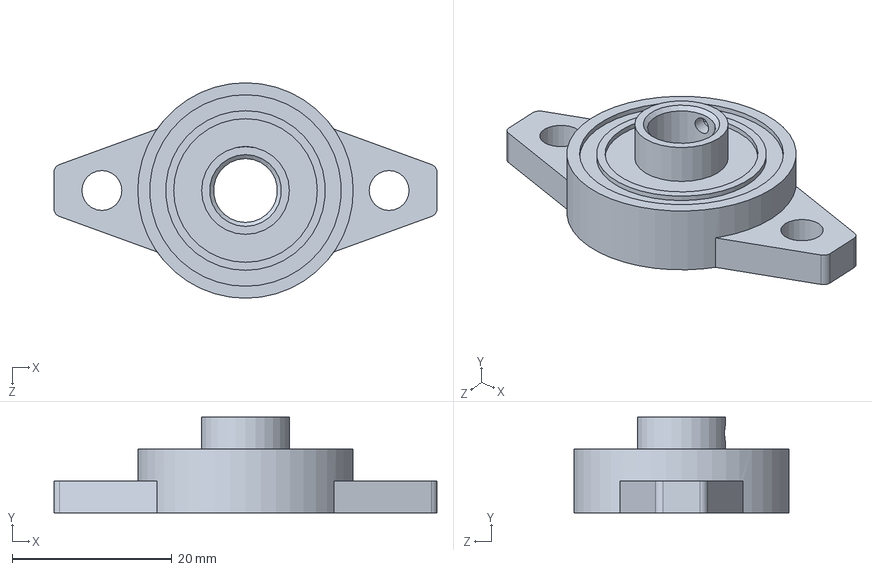
[picture p112: CAD file, 2018-09-17]
文件/参考文献/黄俊淮/3D建模/零件/棘轮轴承M8.SLDPRT
48.0 x 12.0 x 27.0 mm
