KongXiangjie9612/Fruits-picking/文件/设计图纸/毕业设计三维/测绘抓手.SLDPRT

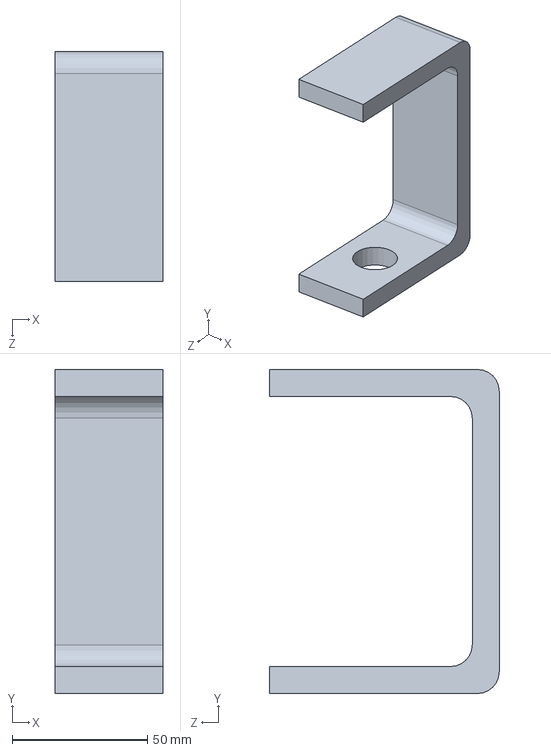
[picture p113: CAD file, 2018-10-24]
文件/设计图纸/毕业设计三维/测绘抓手.SLDPRT
40.0 x 120.0 x 85.0 mm
