KongXiangjie9612/Fruits-picking/文件/参考文献/201430220506邓镇汝/交201430220506邓镇汝/毕业设计三维/手持震动采摘_丝杆螺母.SLDPRT

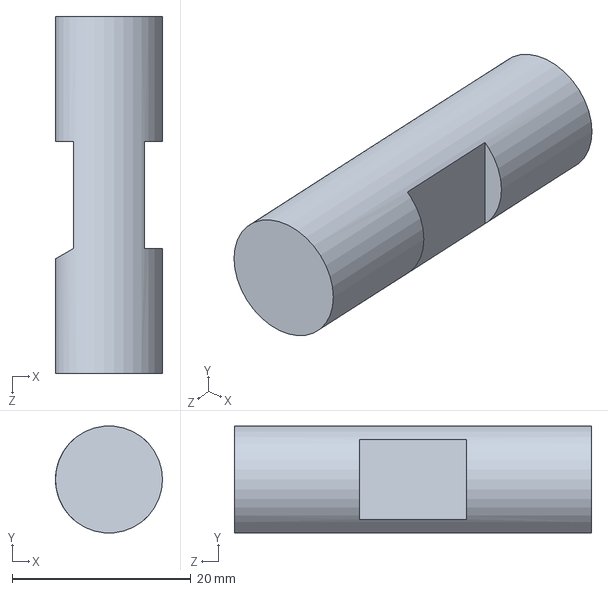
[picture p114: CAD file, 2018-09-26]
文件/参考文献/201430220506邓镇汝/交201430220506邓镇汝/毕业设计三维/手持震动采摘_丝杆螺母.SLDPRT
12.0 x 11.9 x 40.0 mm
