KongXiangjie9612/Fruits-picking/文件/参考文献/陈炜/1.2016.4.8/包含整体棘轮箱-最新/2016.01.06/棘轮箱端面.SLDPRT

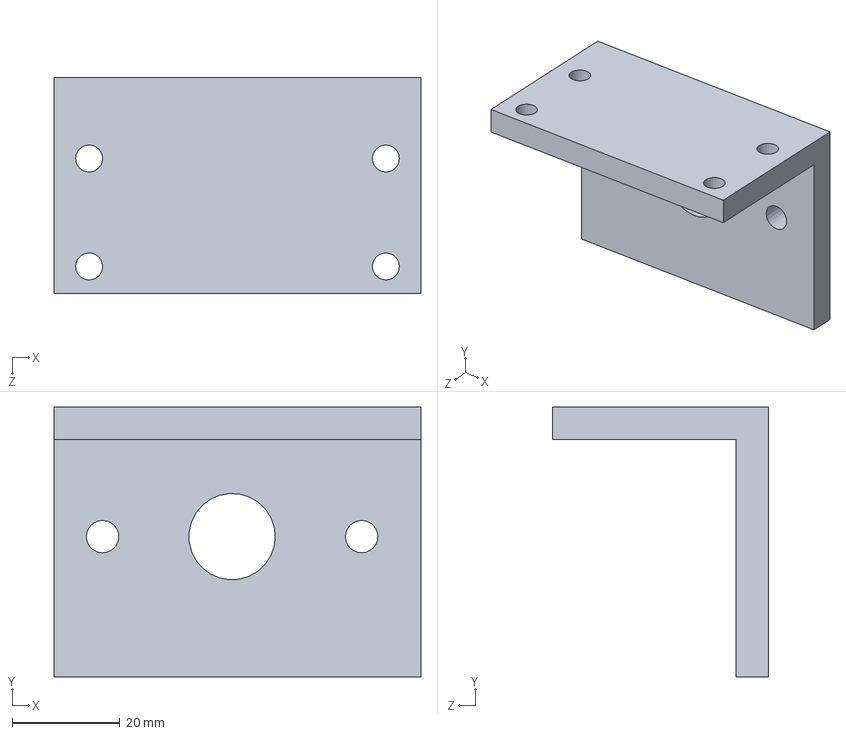
[picture p115: CAD file, 2018-09-17]
文件/参考文献/陈炜/1.2016.4.8/包含整体棘轮箱-最新/2016.01.06/棘轮箱端面.SLDPRT
68.0 x 50.0 x 40.0 mm
