KongXiangjie9612/Fruits-picking/文件/参考文献/黄俊淮/3D建模/标准件/螺钉-M4x8.SLDPRT

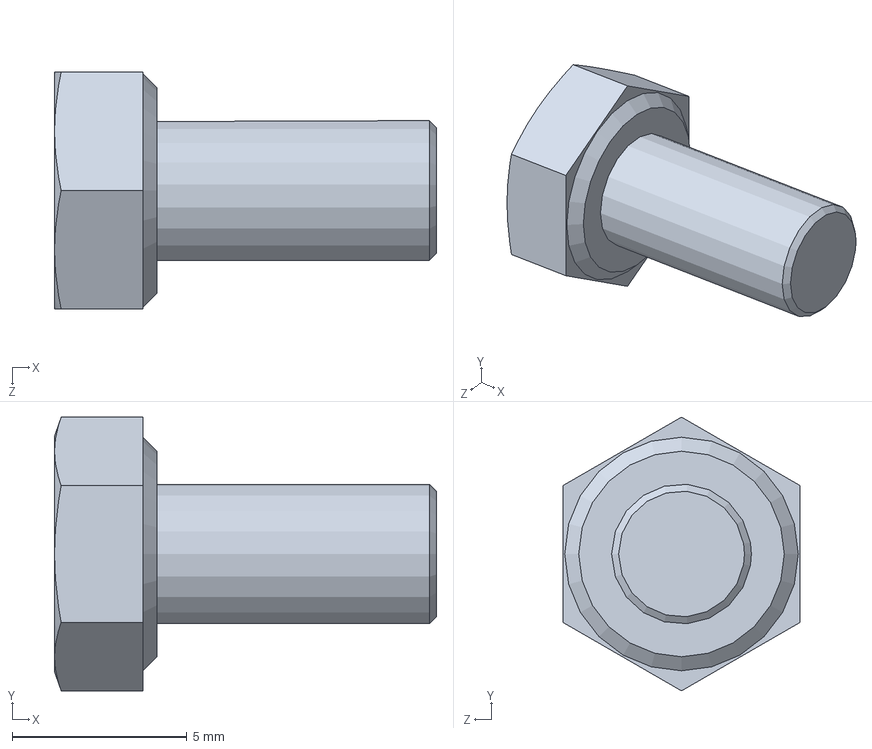
[picture p117: CAD file, 2018-09-17]
文件/参考文献/黄俊淮/3D建模/标准件/螺钉-M4x8.SLDPRT
10.9 x 7.83 x 6.78 mm
