KongXiangjie9612/Fruits-picking/文件/参考文献/黄俊淮/3D建模/零件/棘轮光杆.SLDPRT

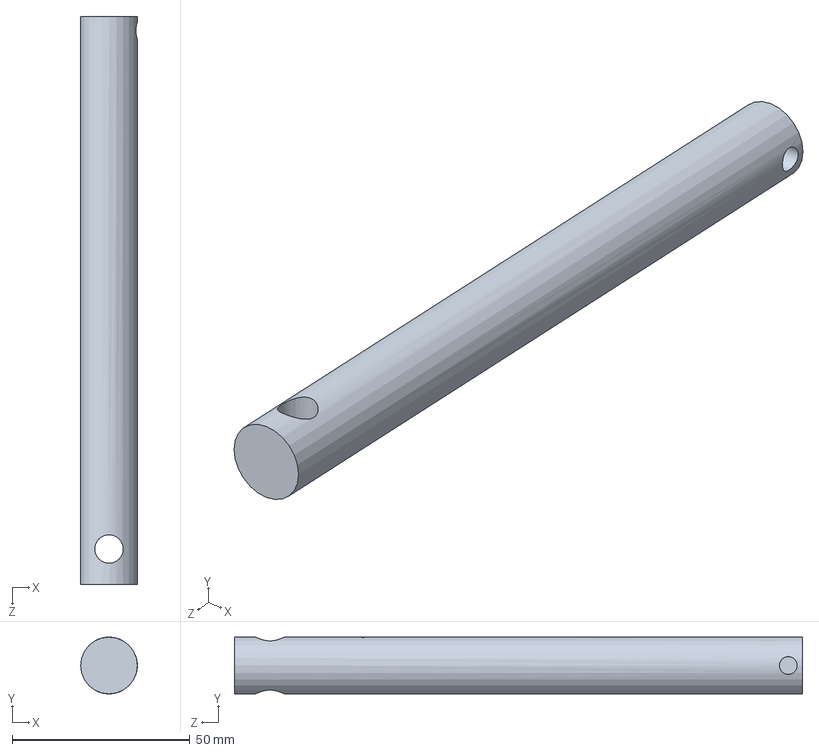
[picture p118: CAD file, 2018-09-17]
文件/参考文献/黄俊淮/3D建模/零件/棘轮光杆.SLDPRT
16.0 x 16.0 x 160.0 mm
