KongXiangjie9612/Fruits-picking/文件/设计图纸/毕业设计三维/夹紧块1.sldprt

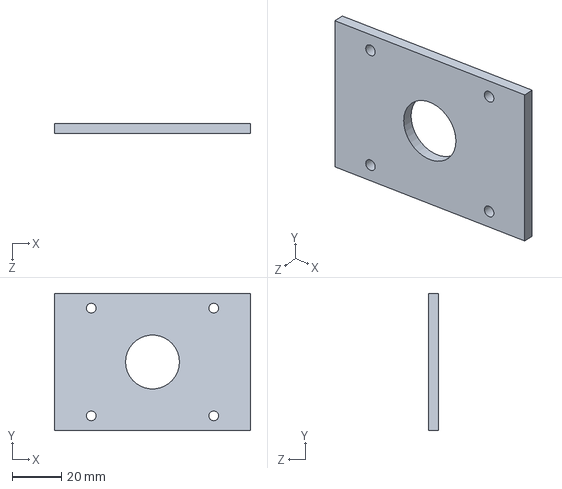
[picture p119: CAD file, 2018-10-24]
文件/设计图纸/毕业设计三维/夹紧块1.sldprt
80.0 x 56.0 x 4.00 mm
