KongXiangjie9612/Fruits-picking/文件/参考文献/201430220506邓镇汝/交201430220506邓镇汝/毕业设计三维/后外部杆.SLDPRT

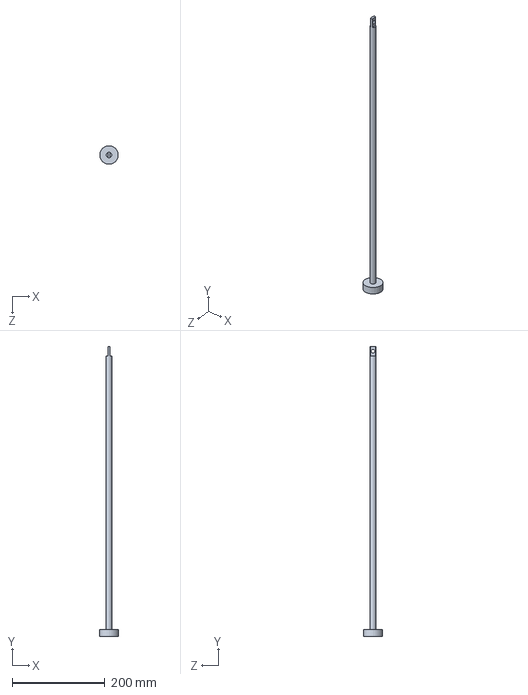
[picture p120: CAD file, 2018-09-26]
文件/参考文献/201430220506邓镇汝/交201430220506邓镇汝/毕业设计三维/后外部杆.SLDPRT
40.0 x 625.0 x 40.0 mm
