KongXiangjie9612/Fruits-picking/文件/参考文献/李康镇/柑橘梳剪采收装置的设计-三维图/梳剪头连接块.SLDPRT

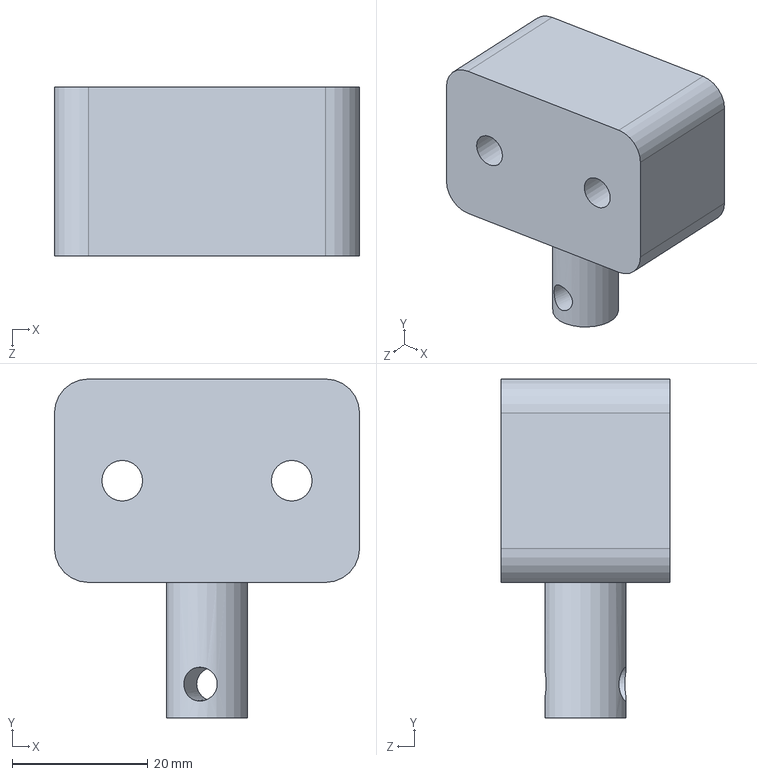
[picture p121: CAD file, 2018-09-17]
文件/参考文献/李康镇/柑橘梳剪采收装置的设计-三维图/梳剪头连接块.SLDPRT
45.0 x 50.0 x 25.0 mm
