KongXiangjie9612/Fruits-picking/文件/参考文献/陈炜/1.2016.4.8/包含整体棘轮箱-最新/2016.01.06/GB／T41-20001型六角螺母C级M5.SLDPRT

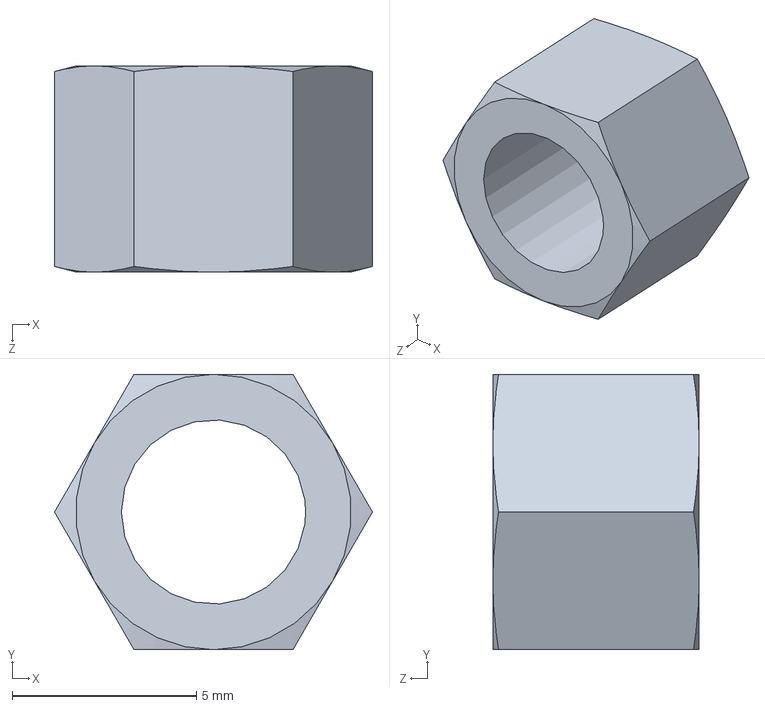
[picture p122: CAD file, 2018-09-17]
文件/参考文献/陈炜/1.2016.4.8/包含整体棘轮箱-最新/2016.01.06/GB／T41-20001型六角螺母C级M5.SLDPRT
8.63 x 7.47 x 5.60 mm
