KongXiangjie9612/Fruits-picking/文件/参考文献/黄俊淮/3D建模/零件/焊接圆块.SLDPRT

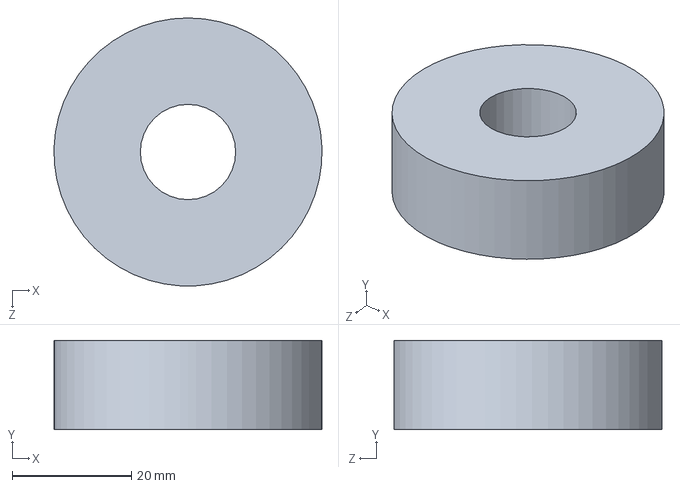
[picture p124: CAD file, 2018-09-17]
文件/参考文献/黄俊淮/3D建模/零件/焊接圆块.SLDPRT
45.0 x 15.0 x 45.0 mm
