KongXiangjie9612/Fruits-picking/文件/设计图纸/毕业设计三维/实际底.SLDPRT

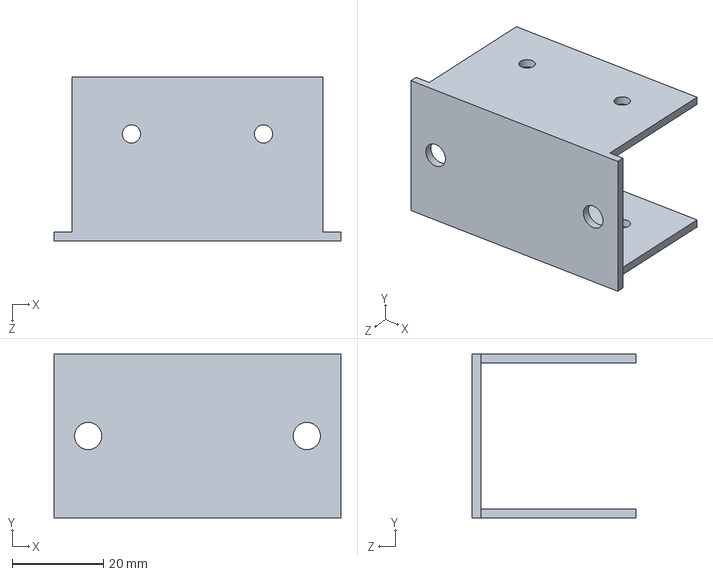
[picture p125: CAD file, 2018-10-24]
文件/设计图纸/毕业设计三维/实际底.SLDPRT
63.0 x 36.0 x 36.0 mm
