KongXiangjie9612/Fruits-picking/文件/参考文献/201430220506邓镇汝/交201430220506邓镇汝/毕业设计三维/手持震动采摘_转盘测速.SLDPRT

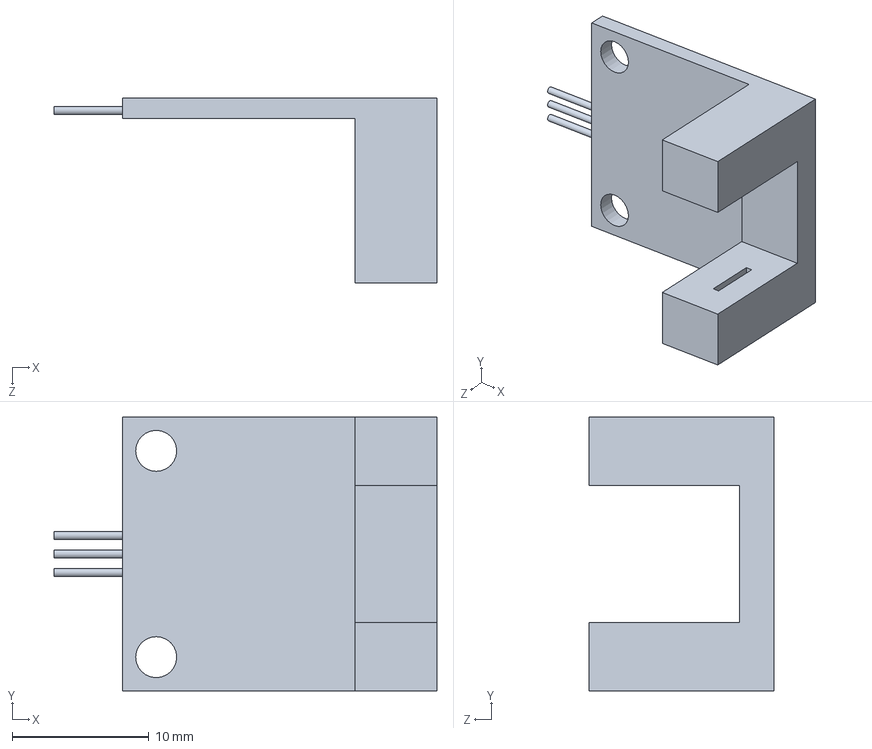
[picture p126: CAD file, 2018-09-26]
文件/参考文献/201430220506邓镇汝/交201430220506邓镇汝/毕业设计三维/手持震动采摘_转盘测速.SLDPRT
28.0 x 20.0 x 13.5 mm
