KongXiangjie9612/Fruits-picking/文件/参考文献/黄俊淮/3D建模/标准件/GB垫片 4.sldprt

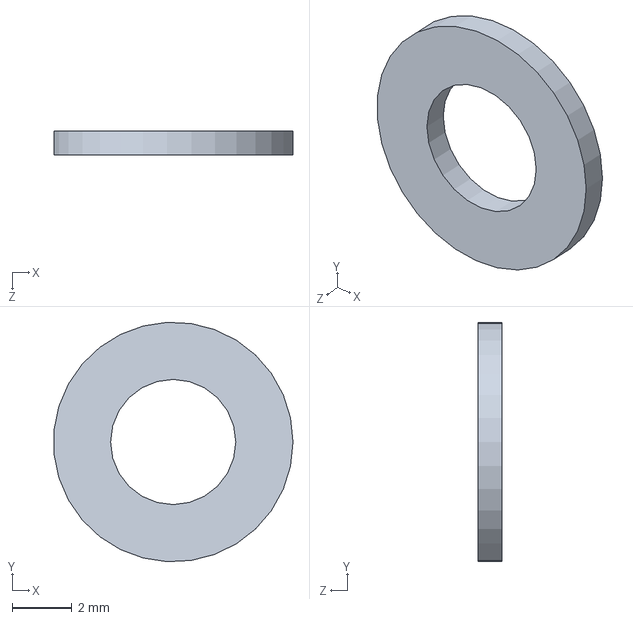
[picture p129: CAD file, 2018-09-17]
文件/参考文献/黄俊淮/3D建模/标准件/GB垫片 4.sldprt
7.98 x 7.99 x 0.8 mm
