KongXiangjie9612/Fruits-picking/文件/参考文献/黄俊淮/3D建模/标准件2/M6螺母.SLDPRT

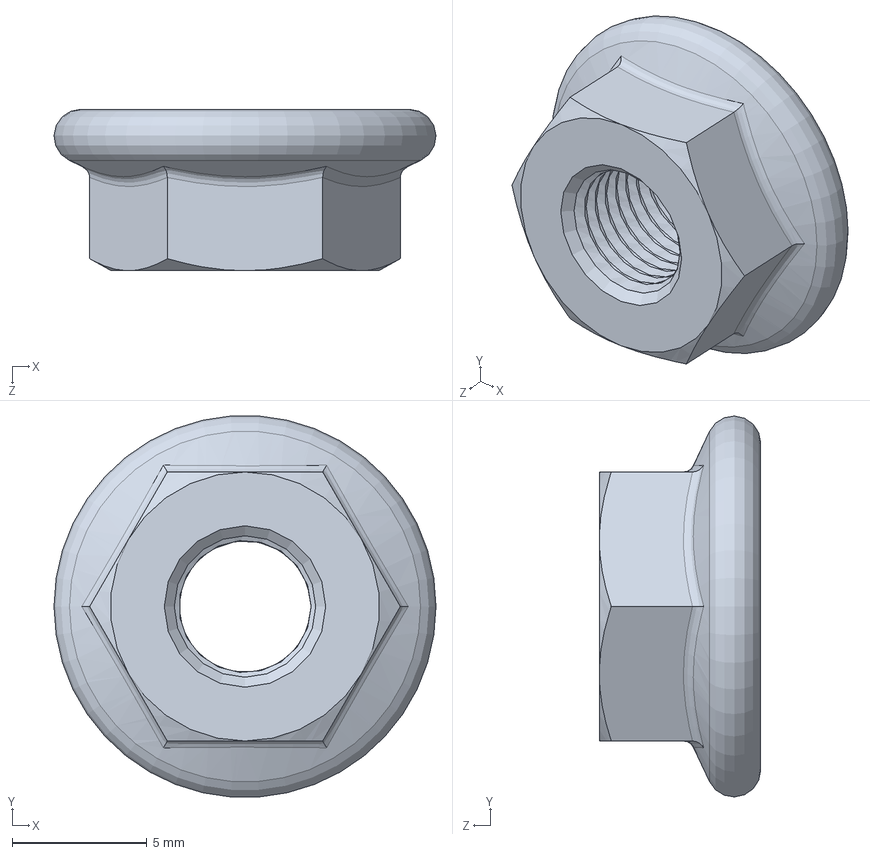
[picture p130: CAD file, 2018-09-17]
文件/参考文献/黄俊淮/3D建模/标准件2/M6螺母.SLDPRT
14.2 x 14.2 x 6.00 mm
