KongXiangjie9612/Fruits-picking/文件/参考文献/黄俊淮/3D建模/零件/曲柄1.SLDPRT

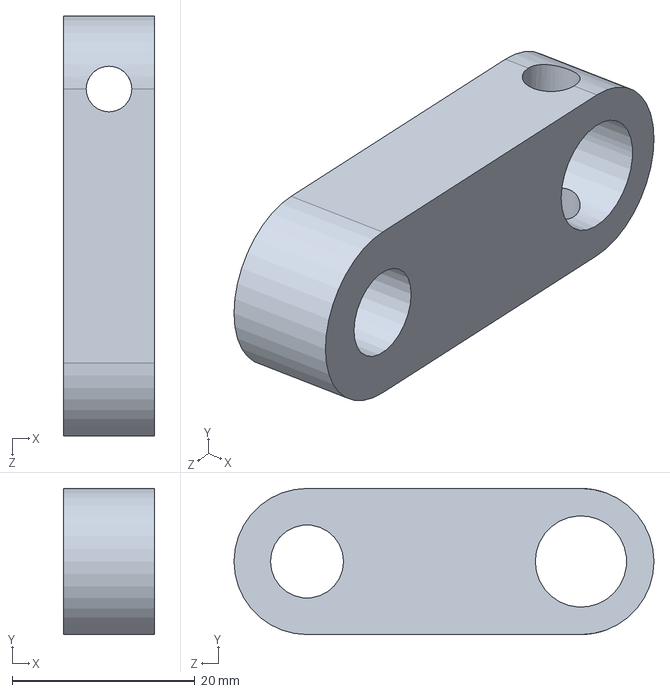
[picture p131: CAD file, 2018-09-17]
文件/参考文献/黄俊淮/3D建模/零件/曲柄1.SLDPRT
10.0 x 16.0 x 46.0 mm
