KongXiangjie9612/Fruits-picking/文件/设计图纸/毕业设计三维/夹紧块2.sldprt

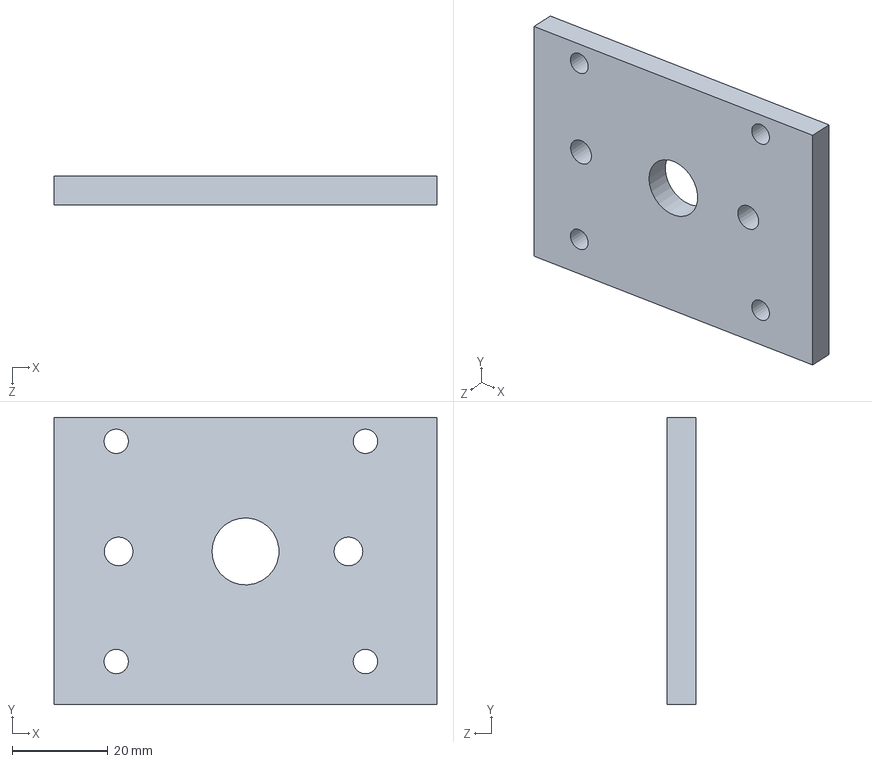
[picture p132: CAD file, 2018-10-24]
文件/设计图纸/毕业设计三维/夹紧块2.sldprt
80.0 x 60.0 x 6.00 mm
