KongXiangjie9612/Fruits-picking/文件/参考文献/黄俊淮/3D建模/零件/棘轮轴10.SLDPRT

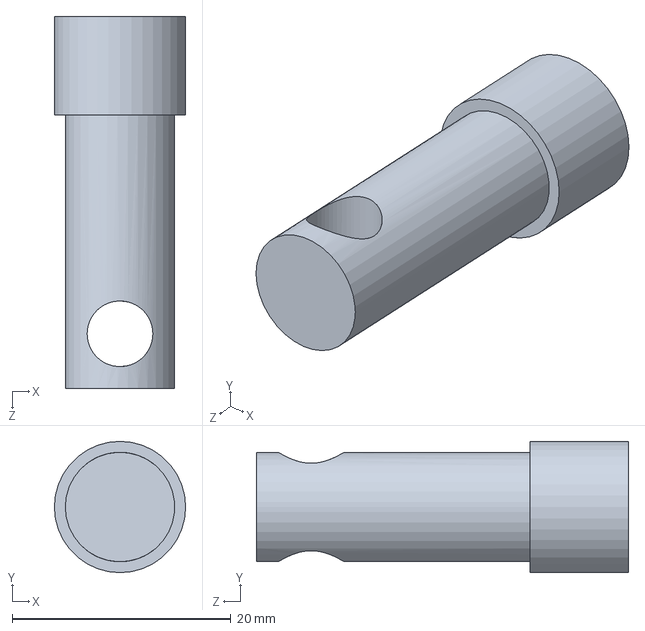
[picture p135: CAD file, 2018-09-17]
文件/参考文献/黄俊淮/3D建模/零件/棘轮轴10.SLDPRT
12.0 x 12.0 x 34.0 mm
