KongXiangjie9612/Fruits-picking/文件/设计图纸/毕业设计三维/丝杆螺母.SLDPRT

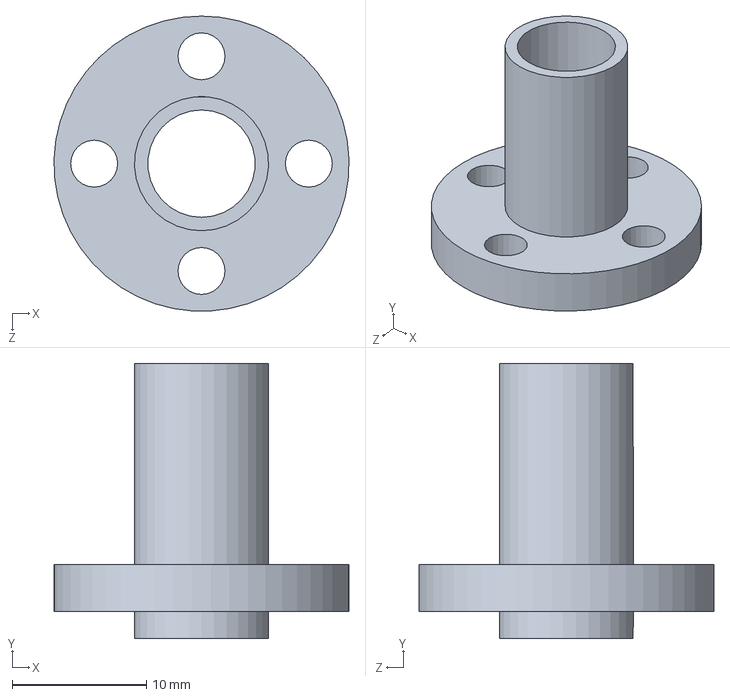
[picture p136: CAD file, 2018-10-24]
文件/设计图纸/毕业设计三维/丝杆螺母.SLDPRT
22.0 x 20.5 x 22.0 mm
