KongXiangjie9612/Fruits-picking/文件/参考文献/李康镇/柑橘梳剪采收装置的设计-三维图/柑橘果实.SLDPRT

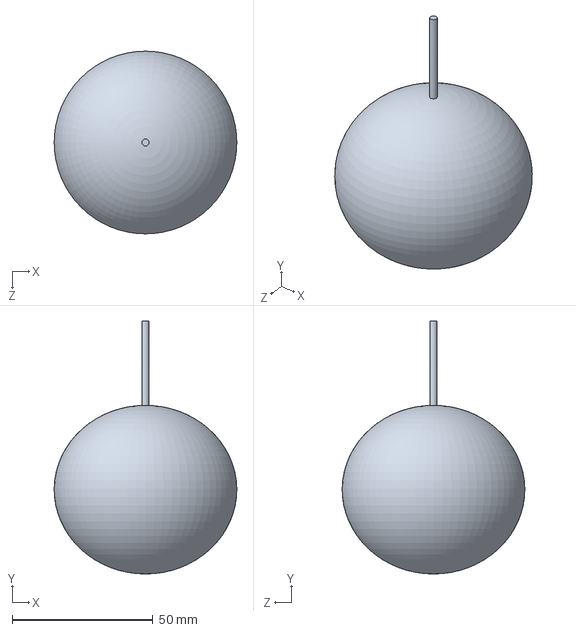
[picture p137: CAD file, 2018-09-17]
文件/参考文献/李康镇/柑橘梳剪采收装置的设计-三维图/柑橘果实.SLDPRT
65.0 x 90.0 x 65.0 mm
