KongXiangjie9612/Fruits-picking/文件/参考文献/陈炜/1.2016.4.8/包含整体棘轮箱-最新/2016.01.20/2016.01.20/棘轮箱轴承支座16.SLDPRT

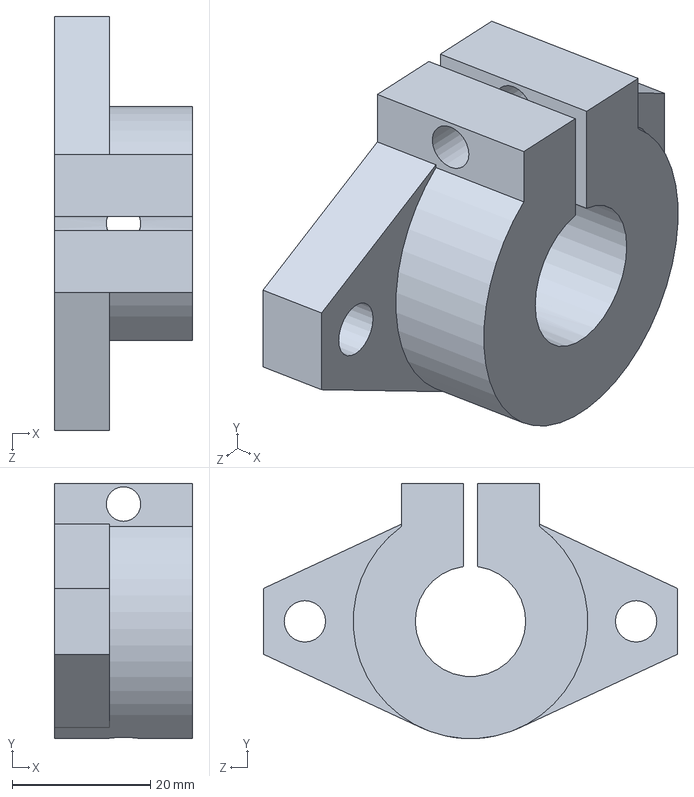
[picture p138: CAD file, 2018-09-17]
文件/参考文献/陈炜/1.2016.4.8/包含整体棘轮箱-最新/2016.01.20/2016.01.20/棘轮箱轴承支座16.SLDPRT
20.0 x 37.0 x 60.0 mm
