KongXiangjie9612/Fruits-picking/文件/参考文献/黄俊淮/3D建模/零件/棘轮箱盖板.SLDPRT

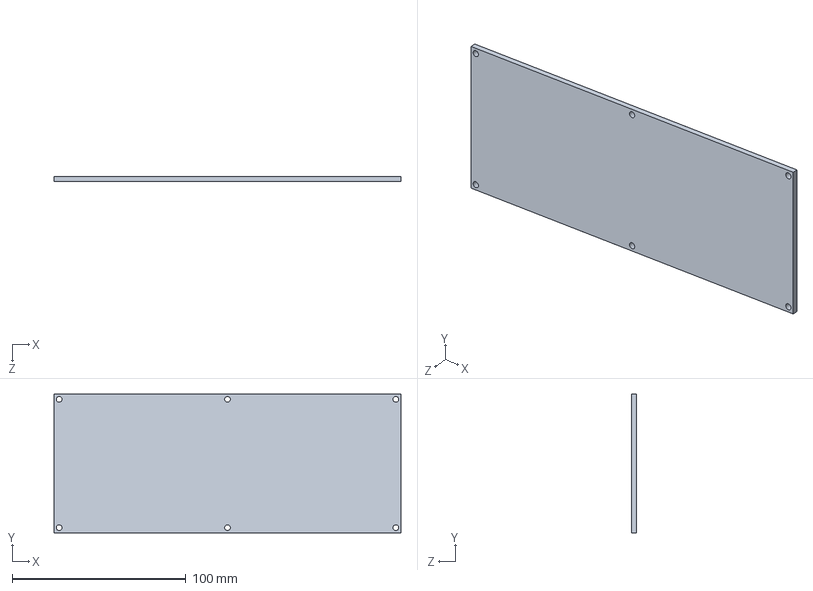
[picture p139: CAD file, 2018-09-17]
文件/参考文献/黄俊淮/3D建模/零件/棘轮箱盖板.SLDPRT
200.0 x 80.0 x 3.00 mm
