KongXiangjie9612/Fruits-picking/文件/参考文献/李康镇/柑橘梳剪采收装置的设计-三维图/箱盖.SLDPRT

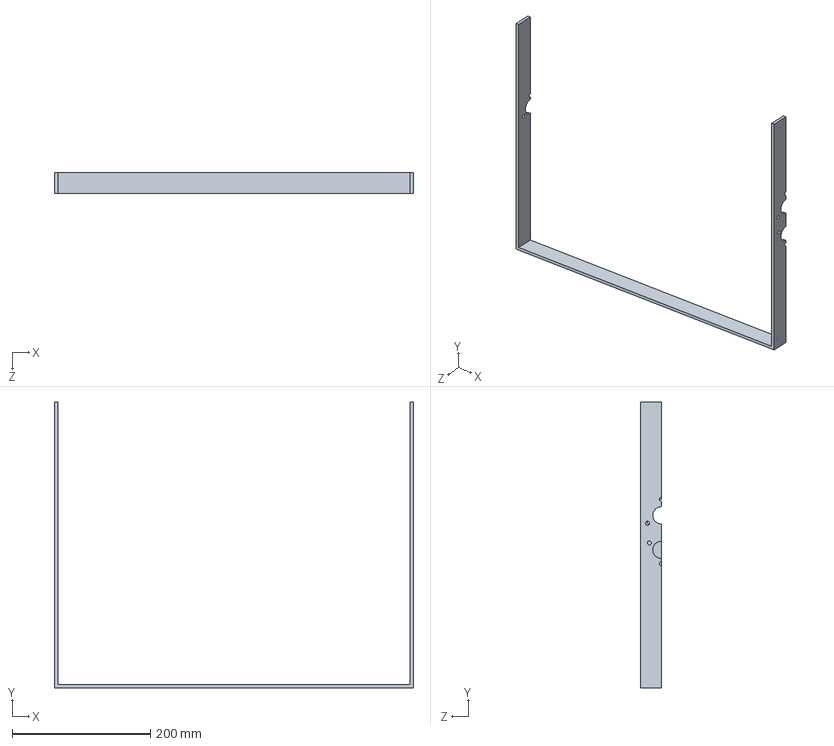
[picture p140: CAD file, 2018-09-17]
文件/参考文献/李康镇/柑橘梳剪采收装置的设计-三维图/箱盖.SLDPRT
520.0 x 414.0 x 30.0 mm
