KongXiangjie9612/Fruits-picking/文件/参考文献/黄俊淮/3D建模/标准件2/Aseembly M4X16.SLDASM

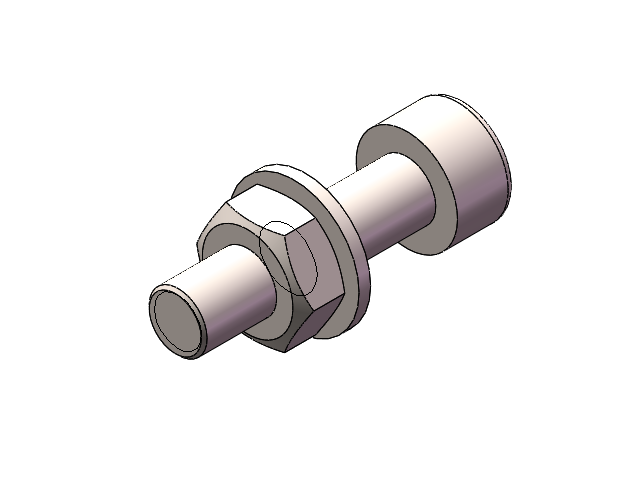
[picture p141: CAD file, 2018-09-17]
文件/参考文献/黄俊淮/3D建模/标准件2/Aseembly M4X16.SLDASM
hex nuts, style 1-grades ab gb
hexagon socket head cap screws gb
plain washers-n series-grade a gb
