KongXiangjie9612/Fruits-picking/(list of files, cad)

Other CAD files:
文件/参考文献/陈炜/1.2016.4.8/包含整体棘轮箱-最新/2016.01.20/2016.01.20/棘轮整体装配体.SLDASM
文件/参考文献/陈炜/1.2016.4.8/包含整体棘轮箱-最新/2016.01.20/2016.01.20/棘轮装配体.SLDASM
文件/参考文献/黄俊淮/3D建模/零件/装配体.SLDASM
文件/参考文献/201430220506邓镇汝/交201430220506邓镇汝/毕业设计二维/螺旋夹紧机构的顶2D5.dwg
文件/参考文献/201430230143-练剑锋/CAD图/上定刀片2.dwg
文件/参考文献/李康镇/毕业设计工程图/装配工程图/梳剪器装配图.dwg
文件/参考文献/李康镇/毕业设计工程图/零件工程图/上安装板.dwg
文件/参考文献/陈炜/装配图.dwg
文件/参考文献/黄俊淮/3D建模/工程图/05_工程图.DWG
文件/参考文献/黄俊淮/二维工程图/装配图（A1两份）.dwg
文件/设计图纸/毕业设计三维/二维a2/棘轮整体箱2Da.dwg
文件/参考文献/201430220506邓镇汝/交201430220506邓镇汝/毕业设计二维/螺旋夹紧机构的中间连接2D5.dwg
文件/参考文献/201430230143-练剑锋/CAD图/引脚.DWG
文件/参考文献/李康镇/毕业设计工程图/装配工程图/梳剪采摘头装配图.dwg
文件/参考文献/李康镇/毕业设计工程图/零件工程图/梳剪头连接块.dwg
文件/参考文献/黄俊淮/3D建模/工程图/01_工程图.DWG
文件/参考文献/黄俊淮/二维工程图/顶片（A4）.dwg
文件/设计图纸/毕业设计三维/二维/连接结构2D5.dwg
文件/设计图纸/毕业设计三维/二维a2/底2Da.dwg
文件/参考文献/201430220506邓镇汝/交201430220506邓镇汝/毕业设计二维/毕业设计装配图.dwg
文件/参考文献/201430230143-练剑锋/CAD图/连杆压板.DWG
文件/参考文献/李康镇/毕业设计工程图/零件工程图/梳齿2.dwg
文件/参考文献/黄俊淮/3D建模/工程图/08_工程图.DWG
文件/参考文献/黄俊淮/二维工程图/抓手（A4）.dwg
文件/设计图纸/毕业设计三维/二维a2/顶2Da.dwg
文件/参考文献/201430220506邓镇汝/交201430220506邓镇汝/毕业设计二维/螺旋夹紧机构的杆2D5.dwg
文件/参考文献/201430230143-练剑锋/CAD图/刀片2.DWG
文件/参考文献/李康镇/毕业设计工程图/零件工程图/梳齿1.dwg
文件/参考文献/黄俊淮/3D建模/工程图/00_工程图.DWG
文件/参考文献/黄俊淮/二维工程图/曲柄（A4）.dwg
文件/设计图纸/毕业设计三维/二维a2/连接结构2Da.dwg
文件/参考文献/201430220506邓镇汝/交201430220506邓镇汝/毕业设计二维/正确的螺旋棒.dwg
文件/参考文献/201430230143-练剑锋/CAD图/上定刀片3.DWG
文件/参考文献/李康镇/毕业设计工程图/零件工程图/驱动盘.dwg
文件/参考文献/黄俊淮/3D建模/工程图/06_工程图.DWG
文件/参考文献/黄俊淮/二维工程图/焊接筒（A4）.dwg
文件/参考文献/201430220506邓镇汝/交201430220506邓镇汝/毕业设计二维/螺旋夹紧机构的底2D5.dwg
文件/参考文献/201430230143-练剑锋/CAD图/上定刀片.dwg
文件/参考文献/李康镇/毕业设计工程图/零件工程图/下安装板.dwg
文件/参考文献/黄俊淮/3D建模/工程图/03_工程图.DWG
文件/参考文献/黄俊淮/3D建模/标准件/GB／T41-20001型六角螺母C级M5.SLDPRT
文件/参考文献/黄俊淮/二维工程图/棘轮轴（A4）.dwg
文件/参考文献/201430220506邓镇汝/交201430220506邓镇汝/毕业设计二维/手柄的连接件.dwg
文件/参考文献/201430230143-练剑锋/CAD图/挡板.DWG
文件/参考文献/李康镇/毕业设计工程图/零件工程图/连杆.dwg
文件/参考文献/黄俊淮/3D建模/工程图/工程图.DWG
文件/参考文献/黄俊淮/二维工程图/棘轮整体箱（A3）.dwg
文件/参考文献/201430220506邓镇汝/交201430220506邓镇汝/毕业设计二维/手柄.dwg
文件/参考文献/201430230143-练剑锋/CAD图/定刀片3.DWG
文件/参考文献/李康镇/毕业设计工程图/零件工程图/橡胶块2.dwg
文件/参考文献/黄俊淮/3D建模/工程图/07_工程图.DWG
文件/参考文献/黄俊淮/二维工程图/连杆（A4）.dwg
文件/参考文献/201430220506邓镇汝/交201430220506邓镇汝/毕业设计二维/连接结构2D5.dwg
文件/参考文献/201430230143-练剑锋/CAD图/定位块.DWG
文件/参考文献/李康镇/毕业设计工程图/零件工程图/偏心轮.dwg
文件/参考文献/黄俊淮/3D建模/工程图/02_工程图.DWG
文件/参考文献/黄俊淮/3D建模/标准件/六角螺母M6-N.sldprt
文件/参考文献/黄俊淮/二维工程图/焊接筒2（A4）.dwg
文件/参考文献/201430230143-练剑锋/CAD图/垫圈.DWG
文件/参考文献/李康镇/毕业设计工程图/零件工程图/橡胶块1.dwg
文件/参考文献/陈炜/1.2016.4.8/包含整体棘轮箱-最新/2016.01.06/弹簧.SLDPRT
文件/参考文献/201430230143-练剑锋/CAD图/偏心轮.dwg
文件/参考文献/201430230143-练剑锋/CAD图/刀片.DWG
文件/参考文献/201430230143-练剑锋/CAD图/定刀片.DWG
文件/参考文献/201430230143-练剑锋/CAD图/定刀片2.DWG
文件/参考文献/201430230143-练剑锋/CAD图/底板.dwg
文件/参考文献/201430230143-练剑锋/CAD图/新柑橘梳剪采收装置单排齿装配体.DWG
文件/参考文献/201430230143-练剑锋/CAD图/橡胶板.DWG
文件/参考文献/201430230143-练剑锋/CAD图/橡胶板下.DWG
文件/参考文献/201430230143-练剑锋/CAD图/电机箱.dwg
文件/参考文献/201430230143-练剑锋/CAD图/盖板.DWG
文件/参考文献/201430230143-练剑锋/CAD图/连杆.dwg
文件/参考文献/201430230143-练剑锋/CAD图/销轴.DWG
文件/参考文献/李康镇/柑橘梳剪采收装置的设计-三维图/M10-20螺钉.SLDPRT
文件/参考文献/李康镇/柑橘梳剪采收装置的设计-三维图/M10法兰螺栓.SLDPRT
文件/参考文献/李康镇/柑橘梳剪采收装置的设计-三维图/M10法兰螺母.SLDPRT
文件/参考文献/李康镇/柑橘梳剪采收装置的设计-三维图/M10螺母.SLDPRT
文件/参考文献/李康镇/柑橘梳剪采收装置的设计-三维图/M10螺钉.SLDPRT
文件/参考文献/李康镇/柑橘梳剪采收装置的设计-三维图/M2-14开口销.SLDPRT
文件/参考文献/李康镇/柑橘梳剪采收装置的设计-三维图/M3-5螺钉.SLDPRT
文件/参考文献/李康镇/柑橘梳剪采收装置的设计-三维图/M3-8螺钉.SLDPRT
文件/参考文献/李康镇/柑橘梳剪采收装置的设计-三维图/M3螺母.SLDPRT
文件/参考文献/李康镇/柑橘梳剪采收装置的设计-三维图/M4-6平端紧定螺钉.SLDPRT
文件/参考文献/李康镇/柑橘梳剪采收装置的设计-三维图/M5-20紧定螺钉.SLDPRT
文件/参考文献/李康镇/柑橘梳剪采收装置的设计-三维图/M5-8紧定螺钉.SLDPRT
文件/参考文献/李康镇/柑橘梳剪采收装置的设计-三维图/M6-16螺钉.SLDPRT
文件/参考文献/李康镇/柑橘梳剪采收装置的设计-三维图/M6-16销轴.SLDPRT
文件/参考文献/李康镇/柑橘梳剪采收装置的设计-三维图/M6-20螺钉.SLDPRT
文件/参考文献/李康镇/柑橘梳剪采收装置的设计-三维图/M6-25螺钉.SLDPRT
文件/参考文献/李康镇/柑橘梳剪采收装置的设计-三维图/M6-35螺钉.SLDPRT
文件/参考文献/李康镇/柑橘梳剪采收装置的设计-三维图/M6-8扁圆头螺钉.SLDPRT
文件/参考文献/李康镇/柑橘梳剪采收装置的设计-三维图/M6螺母.SLDPRT
文件/参考文献/李康镇/柑橘梳剪采收装置的设计-三维图/M8螺母.SLDPRT
文件/参考文献/李康镇/柑橘梳剪采收装置的设计-三维图/PRTBCP2.SLDPRT
文件/参考文献/李康镇/柑橘梳剪采收装置的设计-三维图/PRTDZ1.SLDPRT
文件/参考文献/李康镇/柑橘梳剪采收装置的设计-三维图/PRTQDP.SLDPRT
文件/参考文献/李康镇/柑橘梳剪采收装置的设计-三维图/PRTYP1.SLDPRT
文件/参考文献/李康镇/柑橘梳剪采收装置的设计-三维图/偏心块.SLDPRT
文件/参考文献/李康镇/柑橘梳剪采收装置的设计-三维图/动刀片.SLDPRT
文件/参考文献/李康镇/柑橘梳剪采收装置的设计-三维图/垫圈.SLDPRT
文件/参考文献/李康镇/柑橘梳剪采收装置的设计-三维图/垫圈2.SLDPRT
文件/参考文献/李康镇/柑橘梳剪采收装置的设计-三维图/垫片.SLDPRT
文件/参考文献/李康镇/柑橘梳剪采收装置的设计-三维图/定刀片.SLDPRT
文件/参考文献/李康镇/柑橘梳剪采收装置的设计-三维图/定刀片2.SLDPRT
文件/参考文献/李康镇/柑橘梳剪采收装置的设计-三维图/定刀片3.SLDPRT
文件/参考文献/李康镇/柑橘梳剪采收装置的设计-三维图/底板.SLDPRT
文件/参考文献/李康镇/柑橘梳剪采收装置的设计-三维图/引脚.SLDPRT
文件/参考文献/李康镇/柑橘梳剪采收装置的设计-三维图/弹簧片.SLDPRT
文件/参考文献/李康镇/柑橘梳剪采收装置的设计-三维图/弹簧片固定柱.SLDPRT
文件/参考文献/李康镇/柑橘梳剪采收装置的设计-三维图/接线柱.SLDPRT
文件/参考文献/李康镇/柑橘梳剪采收装置的设计-三维图/接线端子.SLDPRT
文件/参考文献/李康镇/柑橘梳剪采收装置的设计-三维图/橡胶块2.SLDPRT
文件/参考文献/李康镇/柑橘梳剪采收装置的设计-三维图/橡胶片.SLDPRT
文件/参考文献/李康镇/柑橘梳剪采收装置的设计-三维图/滚筒主轴1.SLDPRT
文件/参考文献/李康镇/柑橘梳剪采收装置的设计-三维图/滚筒主轴2.SLDPRT
文件/参考文献/李康镇/柑橘梳剪采收装置的设计-三维图/电机.SLDPRT
文件/参考文献/李康镇/柑橘梳剪采收装置的设计-三维图/电机箱.SLDPRT
文件/参考文献/李康镇/柑橘梳剪采收装置的设计-三维图/电机输出轴.SLDPRT
文件/参考文献/李康镇/柑橘梳剪采收装置的设计-三维图/盖板.SLDPRT
文件/参考文献/李康镇/柑橘梳剪采收装置的设计-三维图/装果容器.SLDPRT
文件/参考文献/李康镇/柑橘梳剪采收装置的设计-三维图/转盘挡板.SLDPRT
文件/参考文献/李康镇/柑橘梳剪采收装置的设计-三维图/轴承61904 GB 276-94.sldprt
文件/参考文献/李康镇/柑橘梳剪采收装置的设计-三维图/轴承座.SLDPRT
文件/参考文献/李康镇/柑橘梳剪采收装置的设计-三维图/连杆2.SLDPRT
文件/参考文献/李康镇/柑橘梳剪采收装置的设计-三维图/连杆压板.SLDPRT
文件/参考文献/李康镇/毕业设计工程图/零件工程图/剪切刀片.dwg
文件/参考文献/李康镇/毕业设计工程图/零件工程图/梳齿3.dwg
文件/参考文献/陈炜/1.2016.4.8/包含整体棘轮箱-最新/2016.01.06/7004cj.SLDPRT
文件/参考文献/陈炜/1.2016.4.8/包含整体棘轮箱-最新/2016.01.06/GB_FASTENER_BOLT_STBAB A M4X8-N.sldprt
文件/参考文献/陈炜/1.2016.4.8/包含整体棘轮箱-最新/2016.01.06/M4螺钉.SLDPRT
文件/参考文献/陈炜/1.2016.4.8/包含整体棘轮箱-最新/2016.01.06/M5X25-N.sldprt
文件/参考文献/陈炜/1.2016.4.8/包含整体棘轮箱-最新/2016.01.06/M6X20-N.sldprt
文件/参考文献/陈炜/1.2016.4.8/包含整体棘轮箱-最新/2016.01.06/M6螺栓.SLDPRT
文件/参考文献/陈炜/1.2016.4.8/包含整体棘轮箱-最新/2016.01.06/M6螺母.SLDPRT
文件/参考文献/陈炜/1.2016.4.8/包含整体棘轮箱-最新/2016.01.06/NMRV040.SLDPRT
文件/参考文献/陈炜/1.2016.4.8/包含整体棘轮箱-最新/2016.01.06/主动销.SLDPRT
文件/参考文献/陈炜/1.2016.4.8/包含整体棘轮箱-最新/2016.01.06/主动销2.SLDPRT
文件/参考文献/陈炜/1.2016.4.8/包含整体棘轮箱-最新/2016.01.06/偏心盘.SLDPRT
文件/参考文献/陈炜/1.2016.4.8/包含整体棘轮箱-最新/2016.01.06/内六角圆柱头螺钉M6X12-C.sldprt
文件/参考文献/陈炜/1.2016.4.8/包含整体棘轮箱-最新/2016.01.06/内六角圆柱头螺钉M6X25-C.sldprt
文件/参考文献/陈炜/1.2016.4.8/包含整体棘轮箱-最新/2016.01.06/卡环20.SLDPRT
文件/参考文献/陈炜/1.2016.4.8/包含整体棘轮箱-最新/2016.01.06/合叶片1.SLDPRT
文件/参考文献/陈炜/1.2016.4.8/包含整体棘轮箱-最新/2016.01.06/合叶片2.SLDPRT
文件/参考文献/陈炜/1.2016.4.8/包含整体棘轮箱-最新/2016.01.06/合叶销.SLDPRT
文件/参考文献/陈炜/1.2016.4.8/包含整体棘轮箱-最新/2016.01.06/圆管夹块.SLDPRT
文件/参考文献/陈炜/1.2016.4.8/包含整体棘轮箱-最新/2016.01.06/夹具销轴.SLDPRT
文件/参考文献/陈炜/1.2016.4.8/包含整体棘轮箱-最新/2016.01.06/定位销.SLDPRT
文件/参考文献/陈炜/1.2016.4.8/包含整体棘轮箱-最新/2016.01.06/平键4X12.SLDPRT
文件/参考文献/陈炜/1.2016.4.8/包含整体棘轮箱-最新/2016.01.06/底板.SLDPRT
文件/参考文献/陈炜/1.2016.4.8/包含整体棘轮箱-最新/2016.01.06/抓手.SLDPRT
文件/参考文献/陈炜/1.2016.4.8/包含整体棘轮箱-最新/2016.01.06/支撑台.SLDPRT
文件/参考文献/陈炜/1.2016.4.8/包含整体棘轮箱-最新/2016.01.06/曲柄1.SLDPRT
文件/参考文献/陈炜/1.2016.4.8/包含整体棘轮箱-最新/2016.01.06/曲柄连杆1.SLDPRT
文件/参考文献/陈炜/1.2016.4.8/包含整体棘轮箱-最新/2016.01.06/曲柄连杆2.SLDPRT
文件/参考文献/陈炜/1.2016.4.8/包含整体棘轮箱-最新/2016.01.06/机箱滑动轴承16-22.SLDPRT
文件/参考文献/陈炜/1.2016.4.8/包含整体棘轮箱-最新/2016.01.06/板1.SLDPRT
文件/参考文献/陈炜/1.2016.4.8/包含整体棘轮箱-最新/2016.01.06/棘轮.SLDPRT
文件/参考文献/陈炜/1.2016.4.8/包含整体棘轮箱-最新/2016.01.06/棘轮光杆.SLDPRT
文件/参考文献/陈炜/1.2016.4.8/包含整体棘轮箱-最新/2016.01.06/棘轮光杆2.SLDPRT
文件/参考文献/陈炜/1.2016.4.8/包含整体棘轮箱-最新/2016.01.06/棘轮凸轮.SLDPRT
文件/参考文献/陈炜/1.2016.4.8/包含整体棘轮箱-最新/2016.01.06/棘轮壳片.SLDPRT
文件/参考文献/陈炜/1.2016.4.8/包含整体棘轮箱-最新/2016.01.06/棘轮盖板.SLDPRT
文件/参考文献/陈炜/1.2016.4.8/包含整体棘轮箱-最新/2016.01.06/棘轮箱底板.SLDPRT
文件/参考文献/陈炜/1.2016.4.8/包含整体棘轮箱-最新/2016.01.06/棘轮箱断面-25.SLDPRT
文件/参考文献/陈炜/1.2016.4.8/包含整体棘轮箱-最新/2016.01.06/棘轮箱轴承支座16.SLDPRT
文件/参考文献/陈炜/1.2016.4.8/包含整体棘轮箱-最新/2016.01.06/棘轮轮齿.SLDPRT
文件/参考文献/陈炜/1.2016.4.8/包含整体棘轮箱-最新/2016.01.06/棘轮轴承M8.SLDPRT
文件/参考文献/陈炜/1.2016.4.8/包含整体棘轮箱-最新/2016.01.06/棘轮连接扳手.SLDPRT
文件/参考文献/陈炜/1.2016.4.8/包含整体棘轮箱-最新/2016.01.06/棘轮顶片.SLDPRT
文件/参考文献/陈炜/1.2016.4.8/包含整体棘轮箱-最新/2016.01.06/棘轮顶片右.SLDPRT
文件/参考文献/陈炜/1.2016.4.8/包含整体棘轮箱-最新/2016.01.06/活动板.SLDPRT
文件/参考文献/陈炜/1.2016.4.8/包含整体棘轮箱-最新/2016.01.06/盖板.SLDPRT
文件/参考文献/陈炜/1.2016.4.8/包含整体棘轮箱-最新/2016.01.06/直角板.SLDPRT
文件/参考文献/陈炜/1.2016.4.8/包含整体棘轮箱-最新/2016.01.06/箱体光杆.SLDPRT
文件/参考文献/陈炜/1.2016.4.8/包含整体棘轮箱-最新/2016.01.06/背带扣环.SLDPRT
文件/参考文献/陈炜/1.2016.4.8/包含整体棘轮箱-最新/2016.01.06/薄铁板.SLDPRT
文件/参考文献/陈炜/1.2016.4.8/包含整体棘轮箱-最新/2016.01.06/螺钉M6X20-20-S.SLDPRT
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
