KongXiangjie9612/Fruits-picking/文件/设计图纸/毕业设计三维/二维/连接结构2D5-Model1.pdf

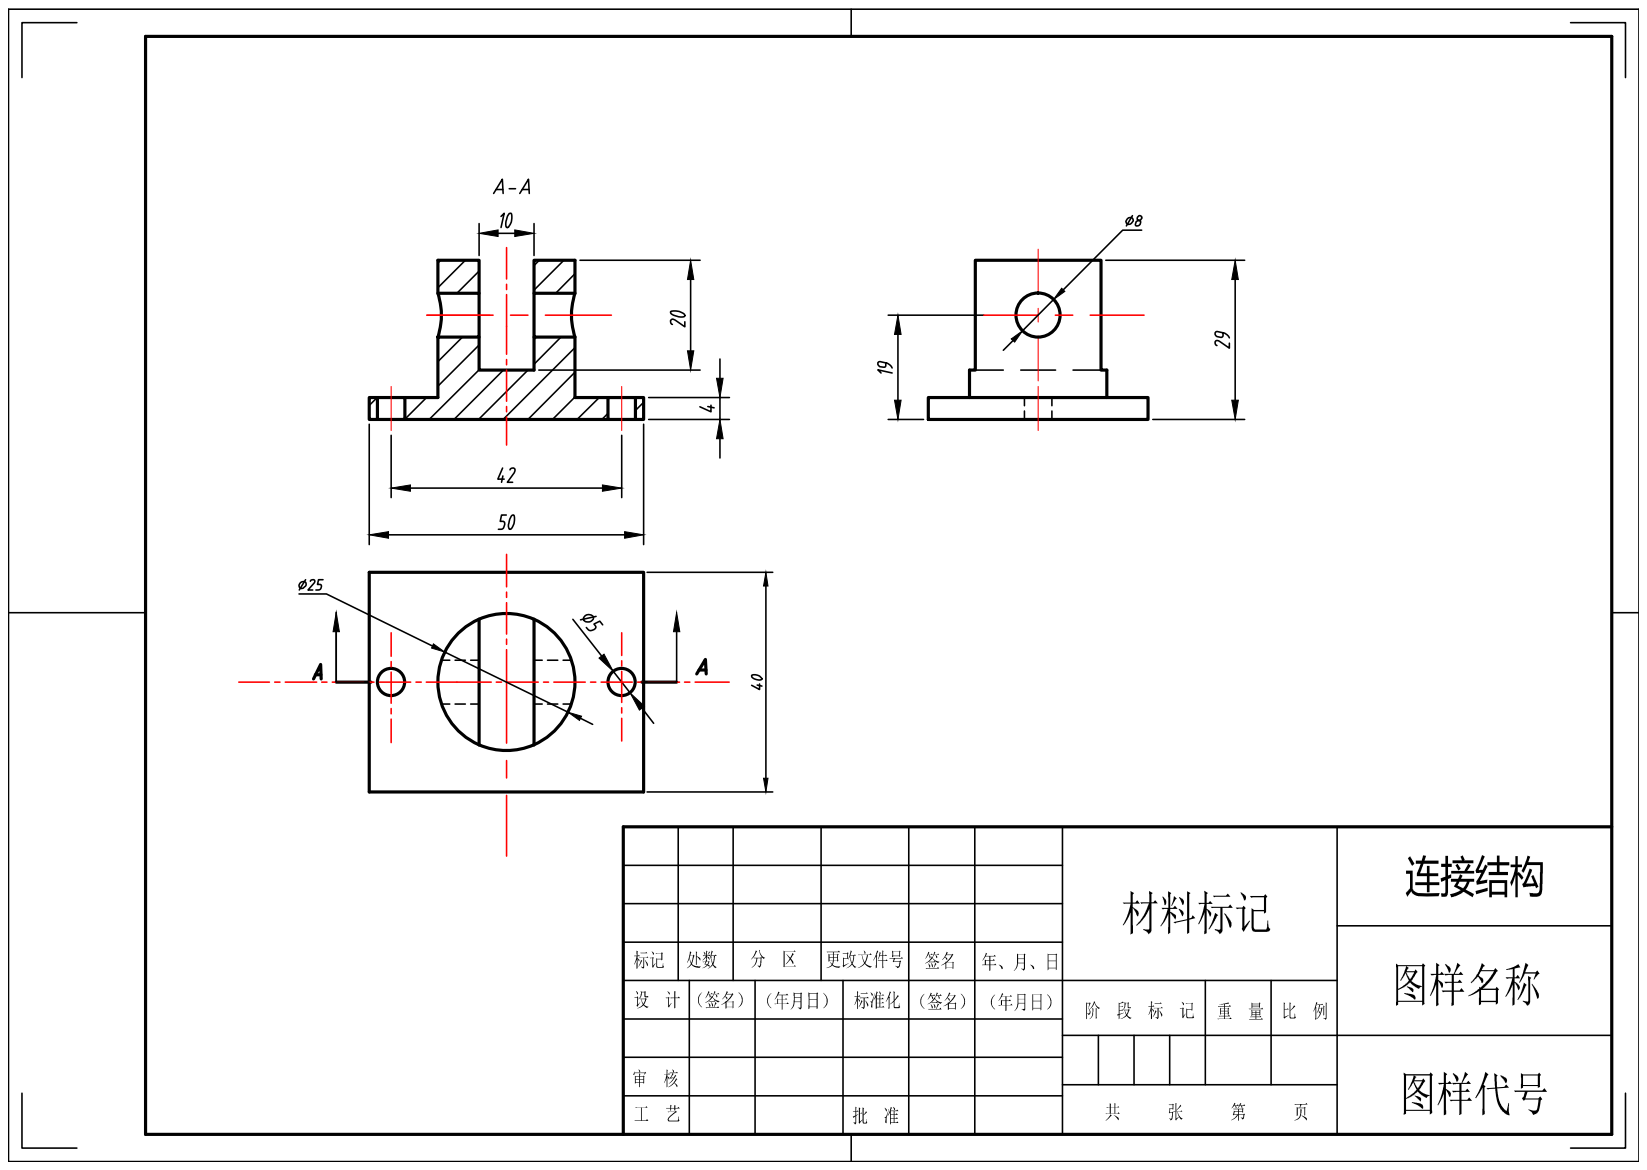
[picture p143: page 1]
