KongXiangjie9612/Fruits-picking/文件/参考文献/黄俊淮/3D建模/工程图/工程图.PDF

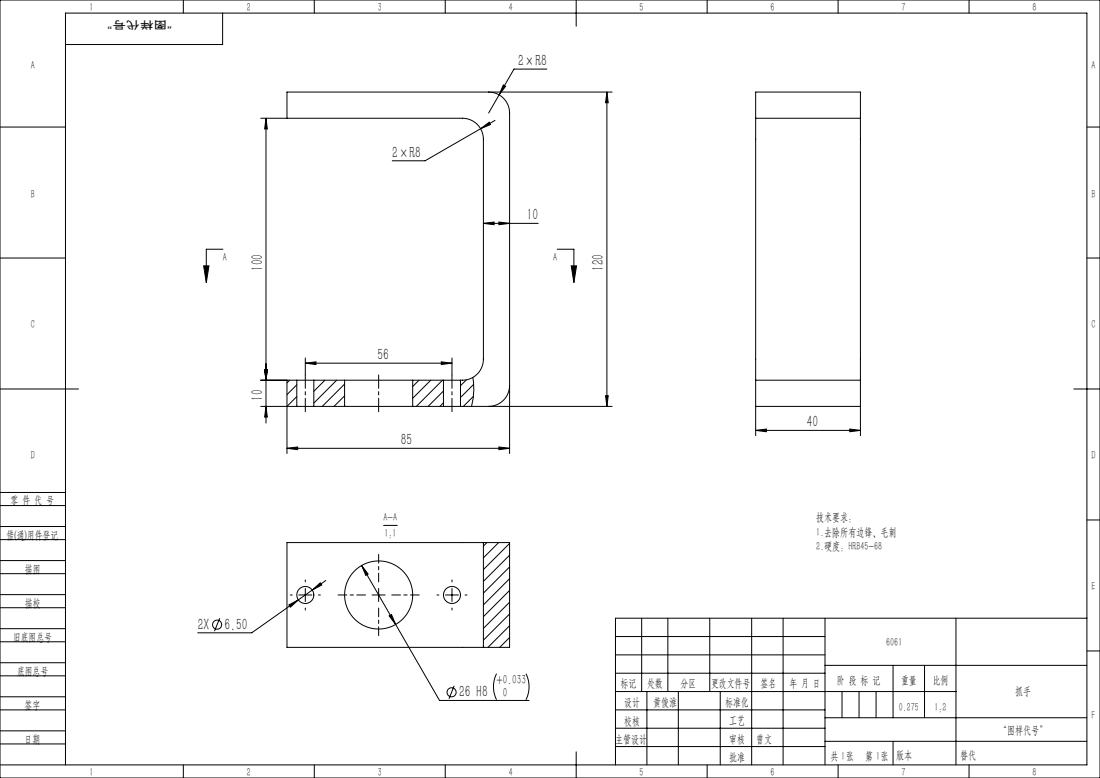
[picture p144: page 1]

标记 | 处数 | 分区 | 更改文件号 | 签名 | 年 月 日
设计 | 黄俊淮 | | 标准化 | | | 0.275 | 1:2
校核 | | | 工艺
主管设计 | | | 审核 | 曾文

“图样代号”
