KongXiangjie9612/Fruits-picking/文件/参考文献/李康镇/毕业设计工程图/PDF图纸/零件工程图/上安装板.pdf

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

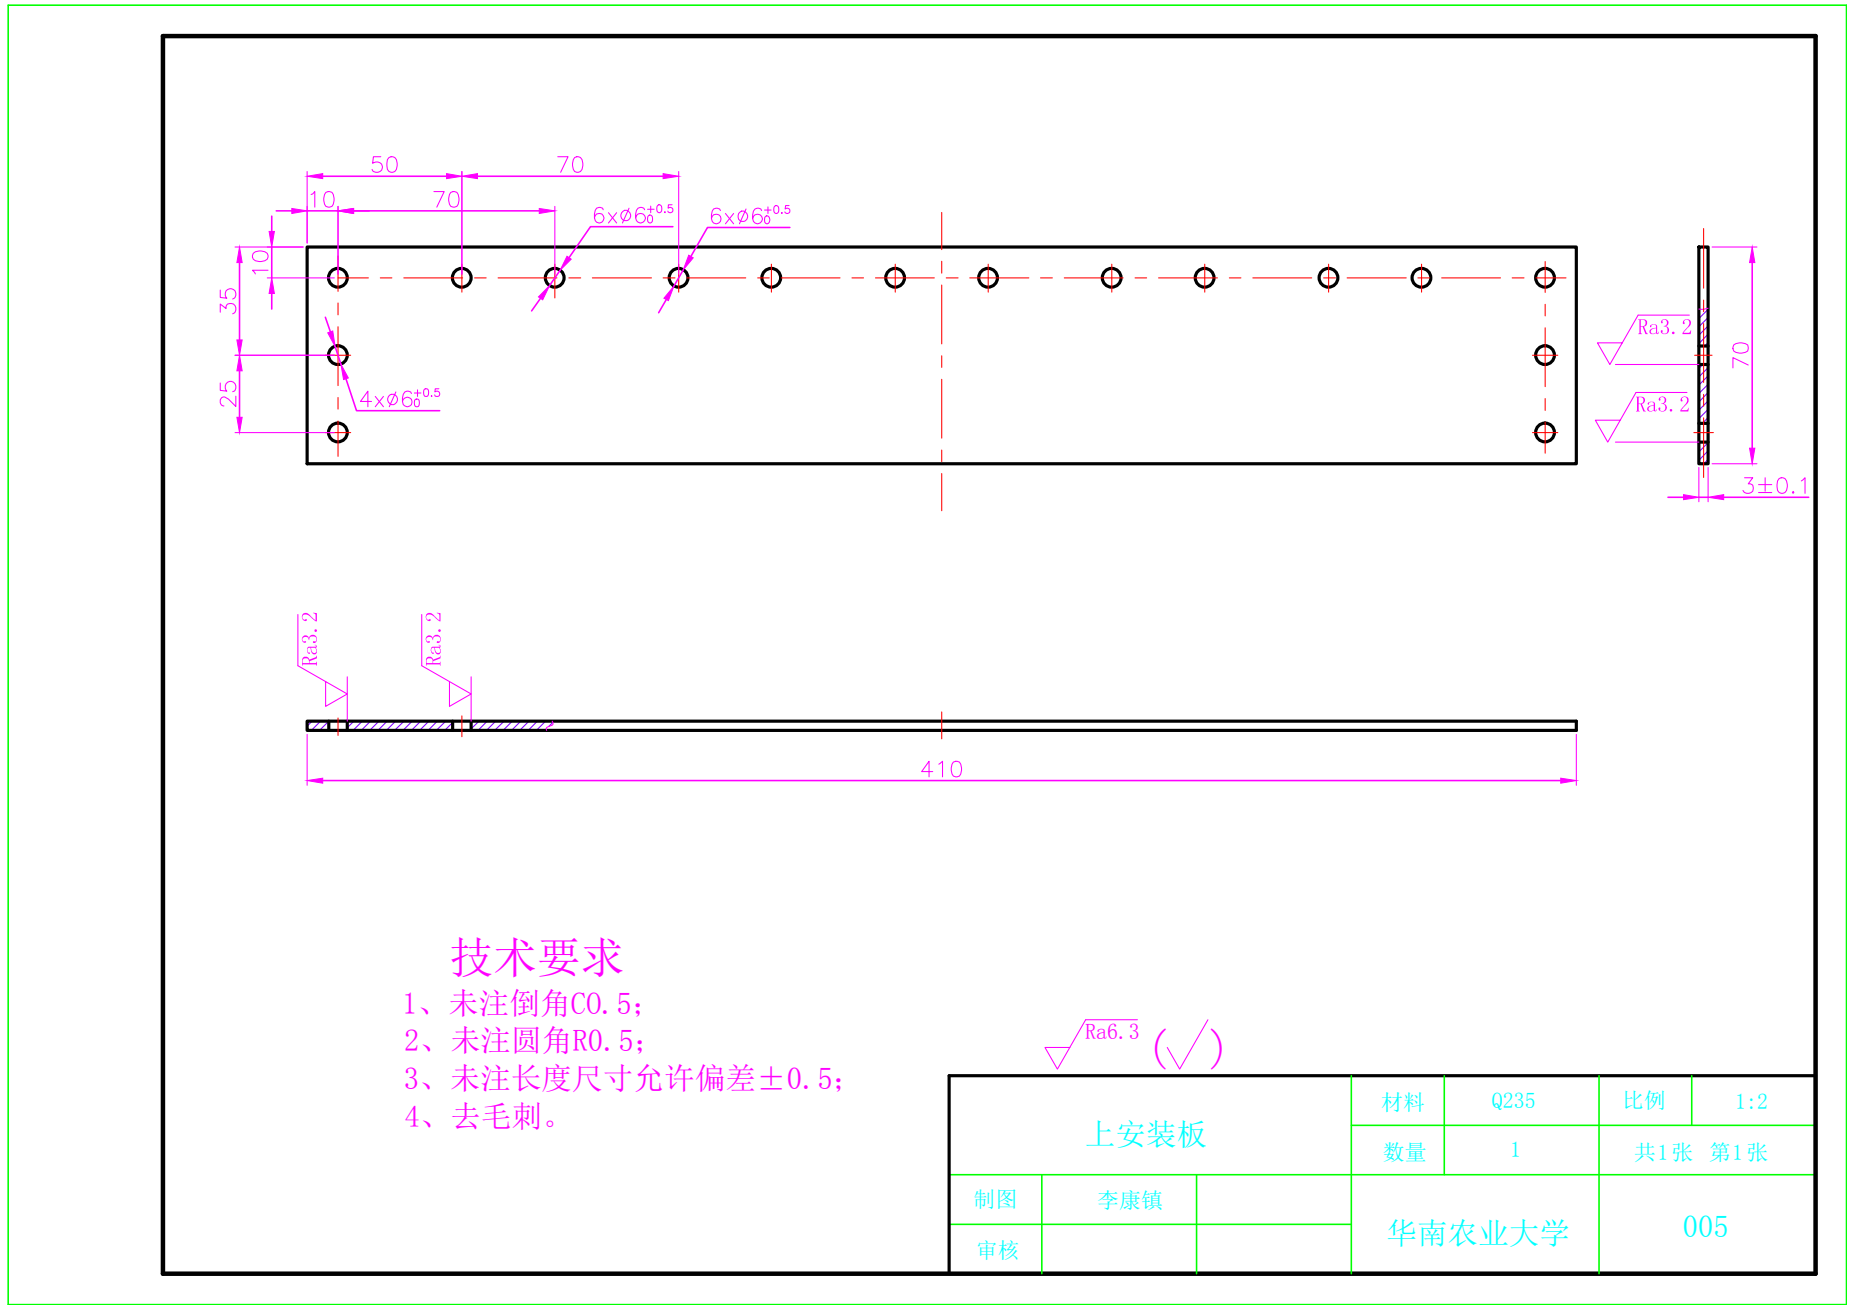
[picture p145: page 1]
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
