KongXiangjie9612/Fruits-picking/(commit log)

2018-09-16 创建项目
2018-09-17 载入文件
    [00_工程图.DWG, 01_工程图.DWG, 02_工程图.DWG, 03_工程图.DWG, 04_工程图.DWG, 05_工程图.DWG, 06_工程图.DWG, 07_工程图.DWG]
2018-09-26 设计图纸修改
    [GB_FASTENER_NUT_SNAB1 M5-C.sldprt, GB_FASTENER_NUT_SNAB1 M6-C.sldprt, GB_FASTENER_NUT_SNAB1 M6-S.sldprt, GB_FASTENER_SCREWS_HSHCS M5X12-C.sldprt, GB_FASTENER_SCREWS_HSHCS M5X12-S.sldprt, GB_FASTENER_SCREWS_HSHCS M6X12-C.sldprt, GB_FASTENER_SCREWS_HSHCS M6X12-S.sldprt, GB_FASTENER_SCREWS_HSHCS M8X40-C.sldprt]
2018-10-03 修改零部件
    [后外部杆.SLDPRT, 实际底.SLDPRT, 手持震动采摘_丝杆.SLDPRT, 手持震动采摘_丝杆电机电机座.SLDPRT, 手持震动采摘_丝杆螺母.SLDPRT, 手轮.SLDPRT, 杆.SLDPRT, 棘轮整体箱.SLDPRT]
2018-10-12 在加工折弯件、外壳槽、丝杆连接件、测速罩
    [测绘装配2.SLDASM, 测速支架.SLDPRT, 码盘.SLDPRT, 零件6.sldprt, 零件7.sldprt]
2018-10-19 讨论后修改
    [丝杆螺母.SLDPRT, 后外部杆.SLDPRT, 外罩.SLDPRT, 夹紧块.sldprt, 实际底.SLDPRT, 手持式震动采摘_零件清单.xlsx, 手持震动采摘_丝杆电机电机座.SLDPRT, 棘轮整体箱.SLDPRT]
2018-10-24 最终版1
    [18，22管.SLDPRT, 丝杆螺母.SLDPRT, 伸出最长的长度.SLDPRT, 后外部杆.SLDPRT, 外罩.SLDPRT, 外部杆.SLDPRT, 夹紧块.sldprt, 夹紧块1.sldprt]
